antmicro/ecp5-dc-scm/img/diagram.png

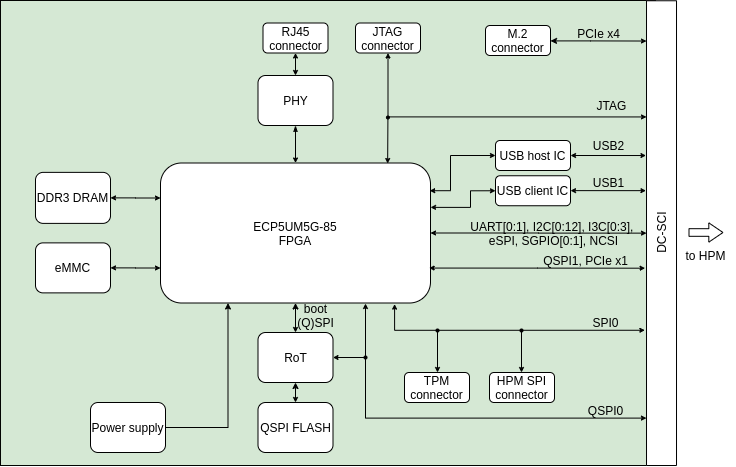
img/diagram.png
