antmicro/ecp5-dc-scm/doc/ecp5-dc-scm.pdf

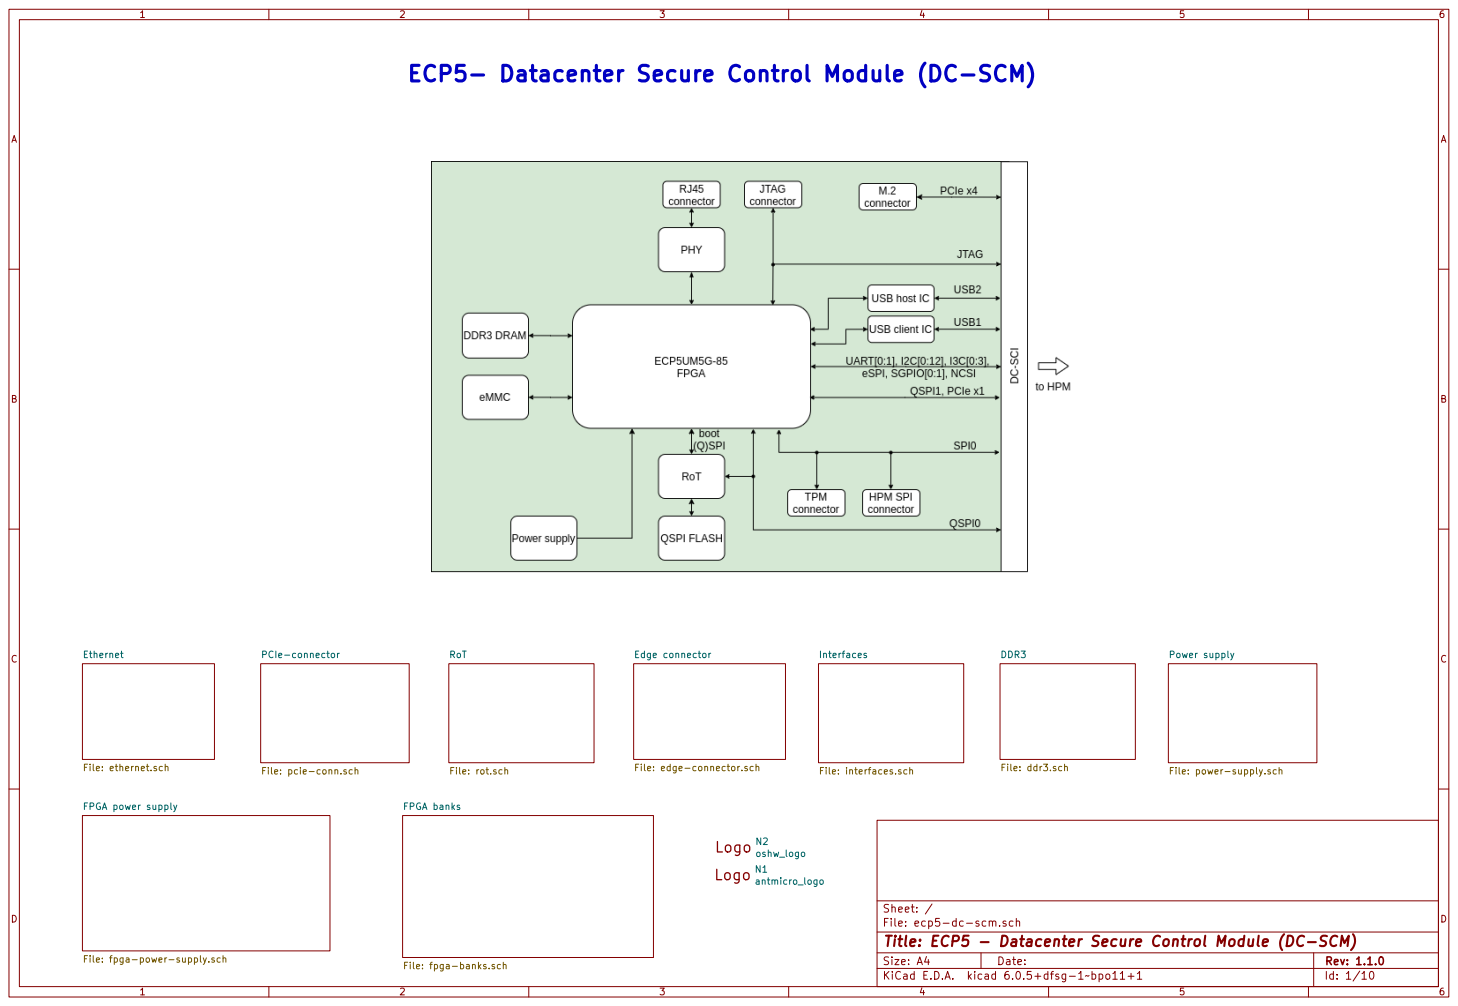
[picture p4: page 1]

ECP5- Datacenter Secure Control Module (DC-SCM)

File: ecp5-dc-scm.sch Sheet: / Edge connector

File: rot.sch FPGA power supply

File: edge-connector.sch

Id: 1/10 Title: ECP5 - Datacenter Secure Control Module (DC-SCM)

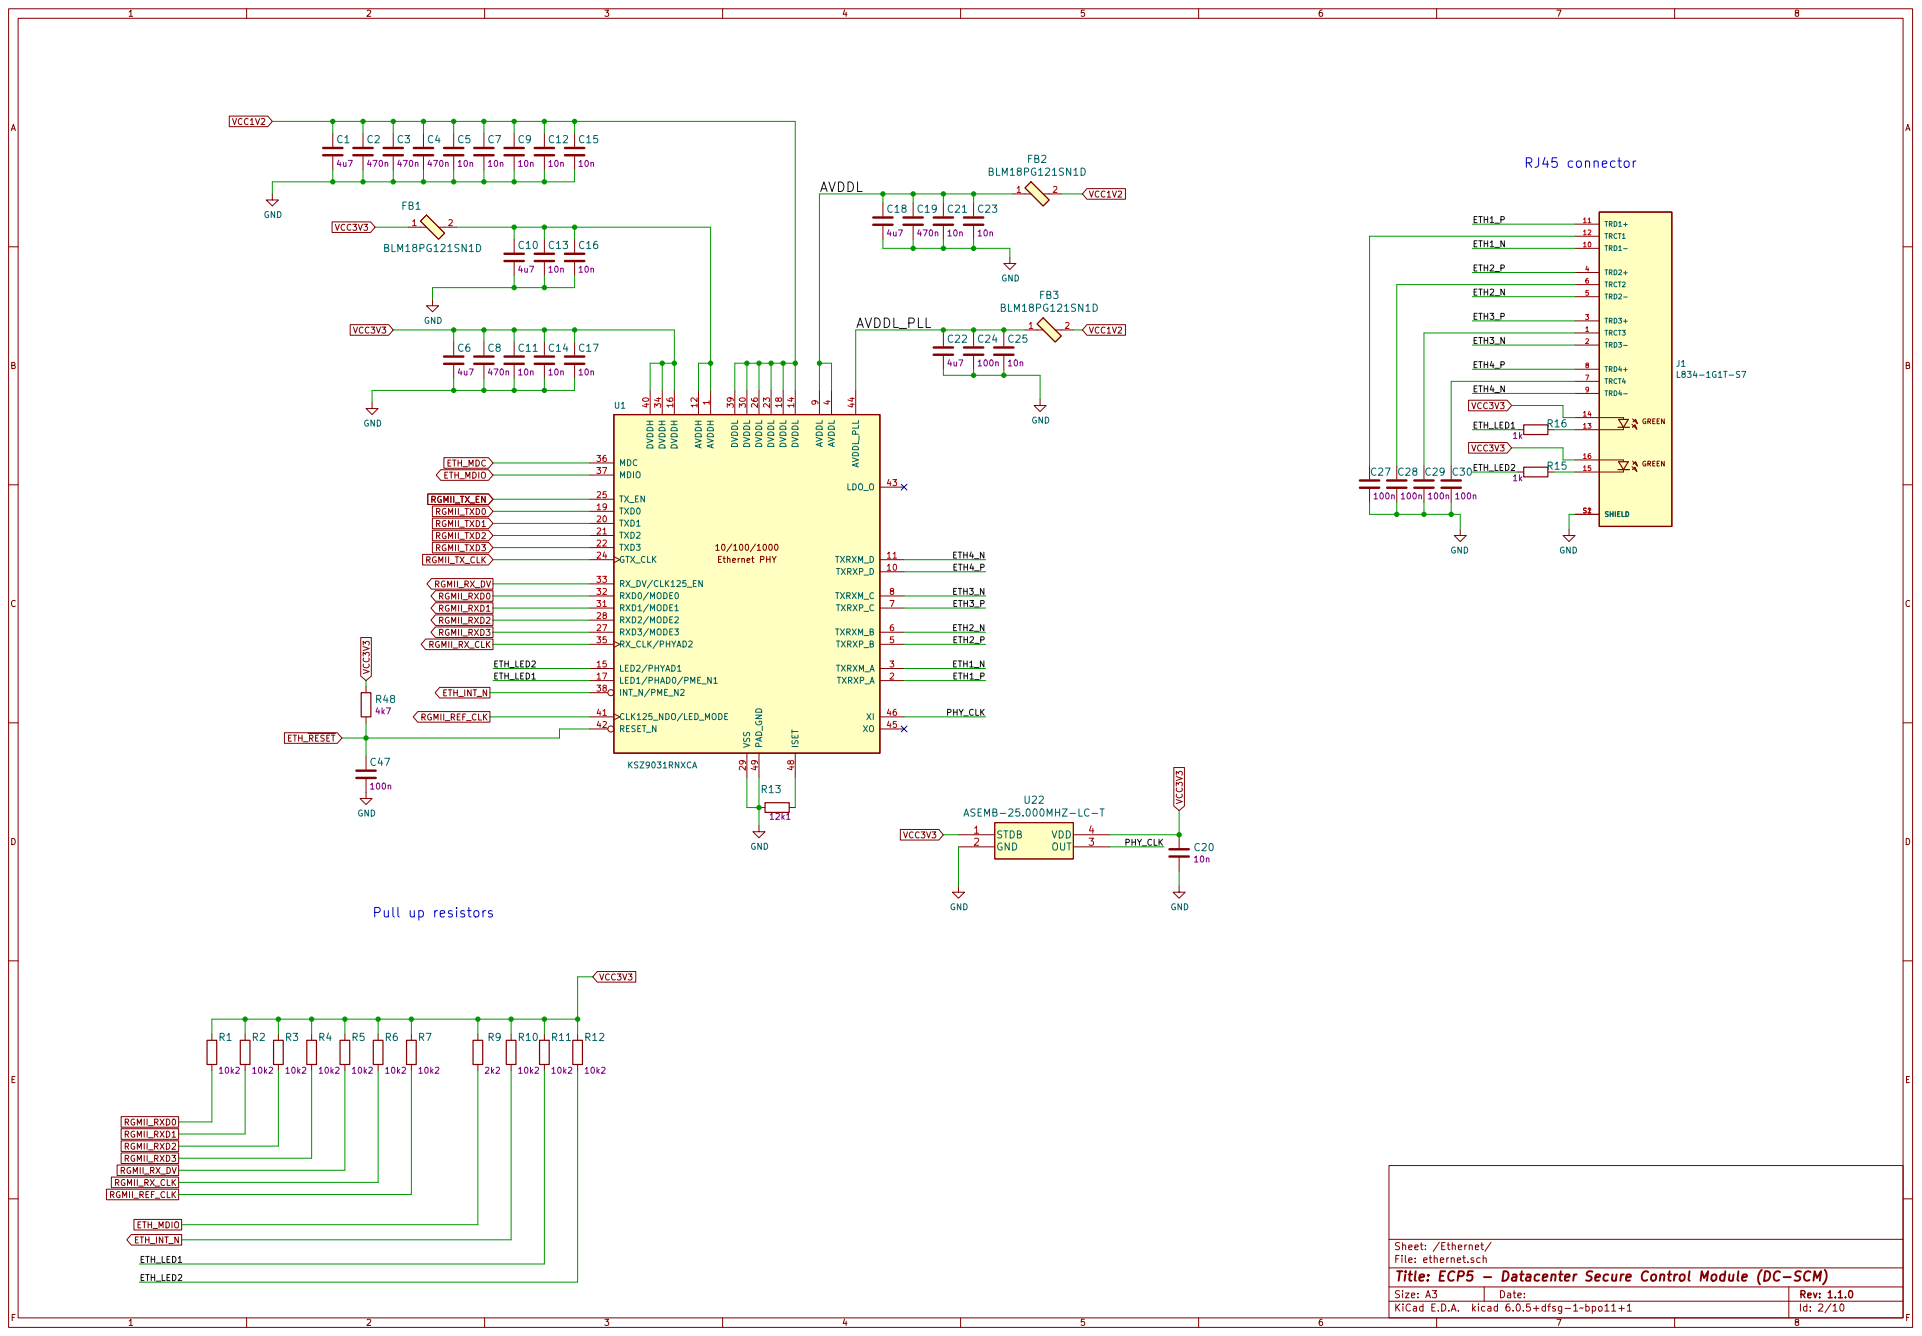
[picture p5: page 2]

Id: 2/10 Title: ECP5 - Datacenter Secure Control Module (DC-SCM) File: ethernet.sch Sheet: /Ethernet/

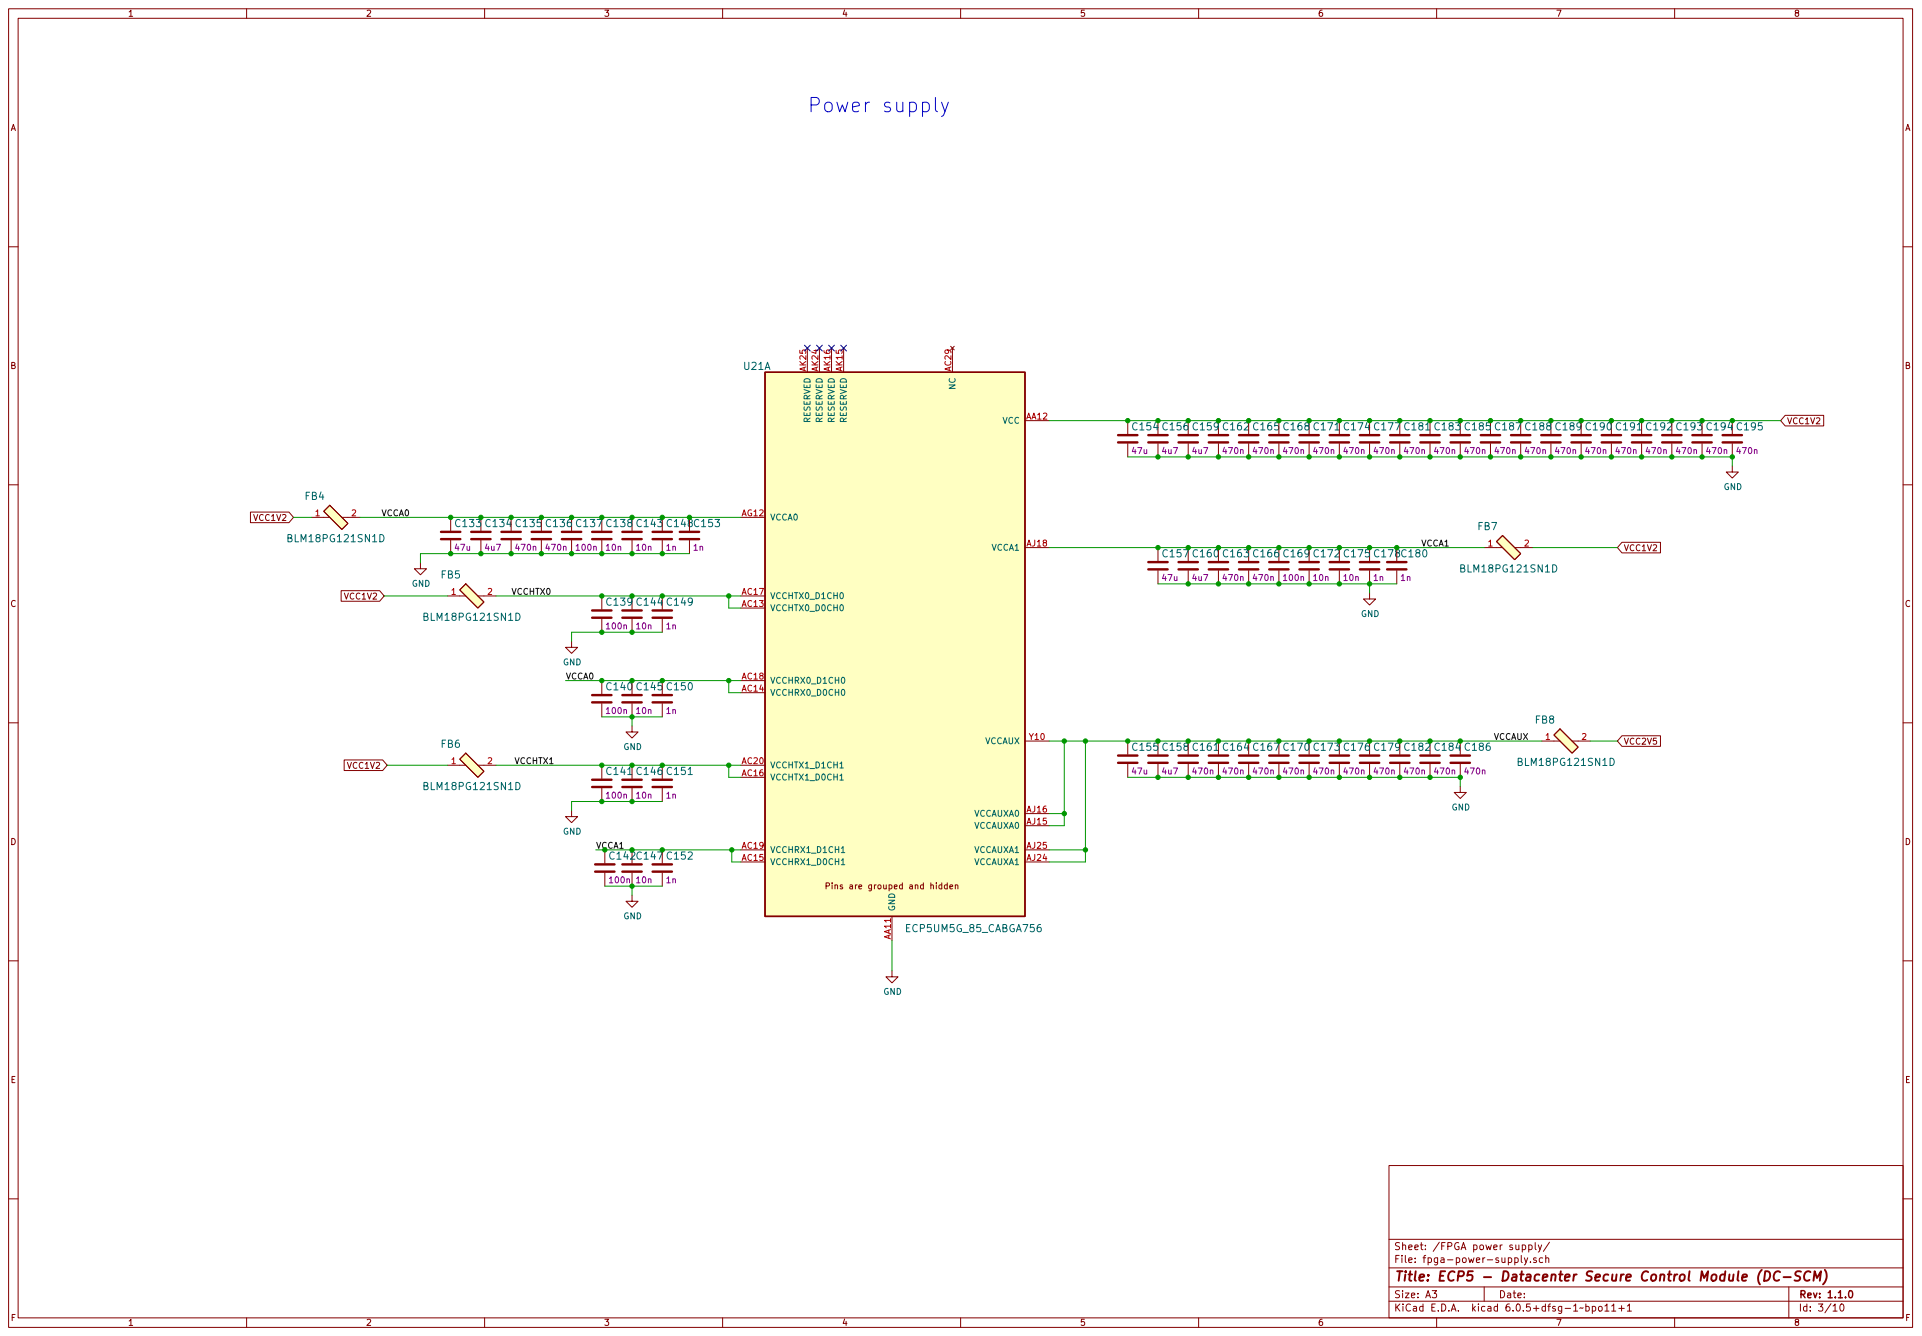
[picture p6: page 3]

Sheet: /FPGA power supply/
File: fpga-power-supply.sch
Id: 3/10 Title: ECP5 - Datacenter Secure Control Module (DC-SCM)

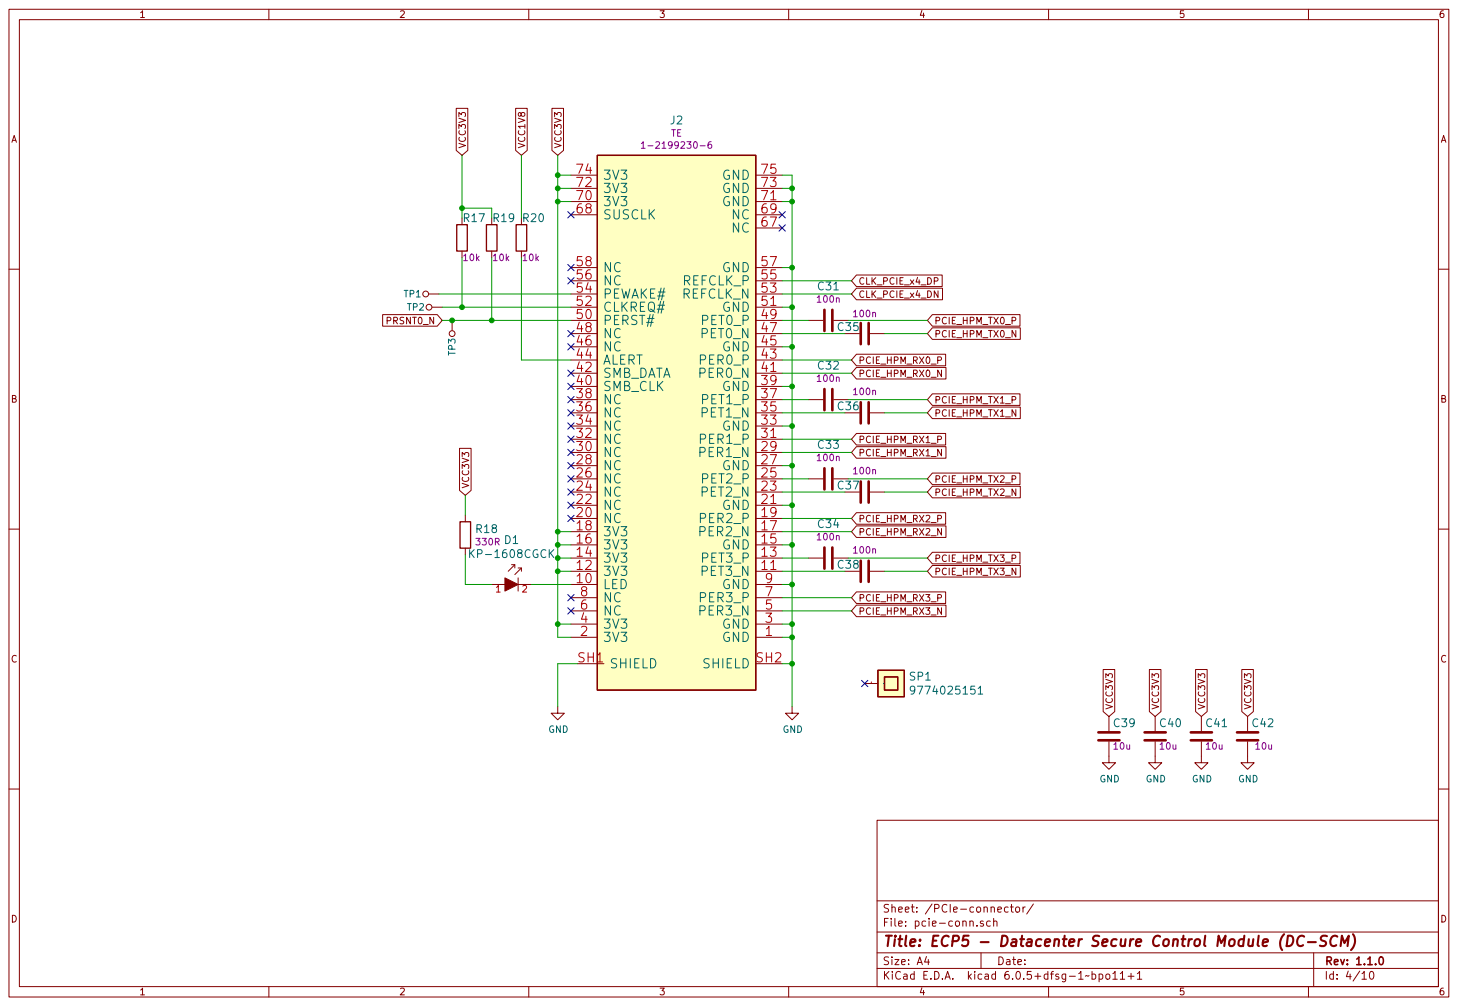
[picture p7: page 4]

1-2199230-6 GND R18
File: pcie-conn.sch Sheet: /PCIe-connector/ C34

Id: 4/10 Title: ECP5 - Datacenter Secure Control Module (DC-SCM)

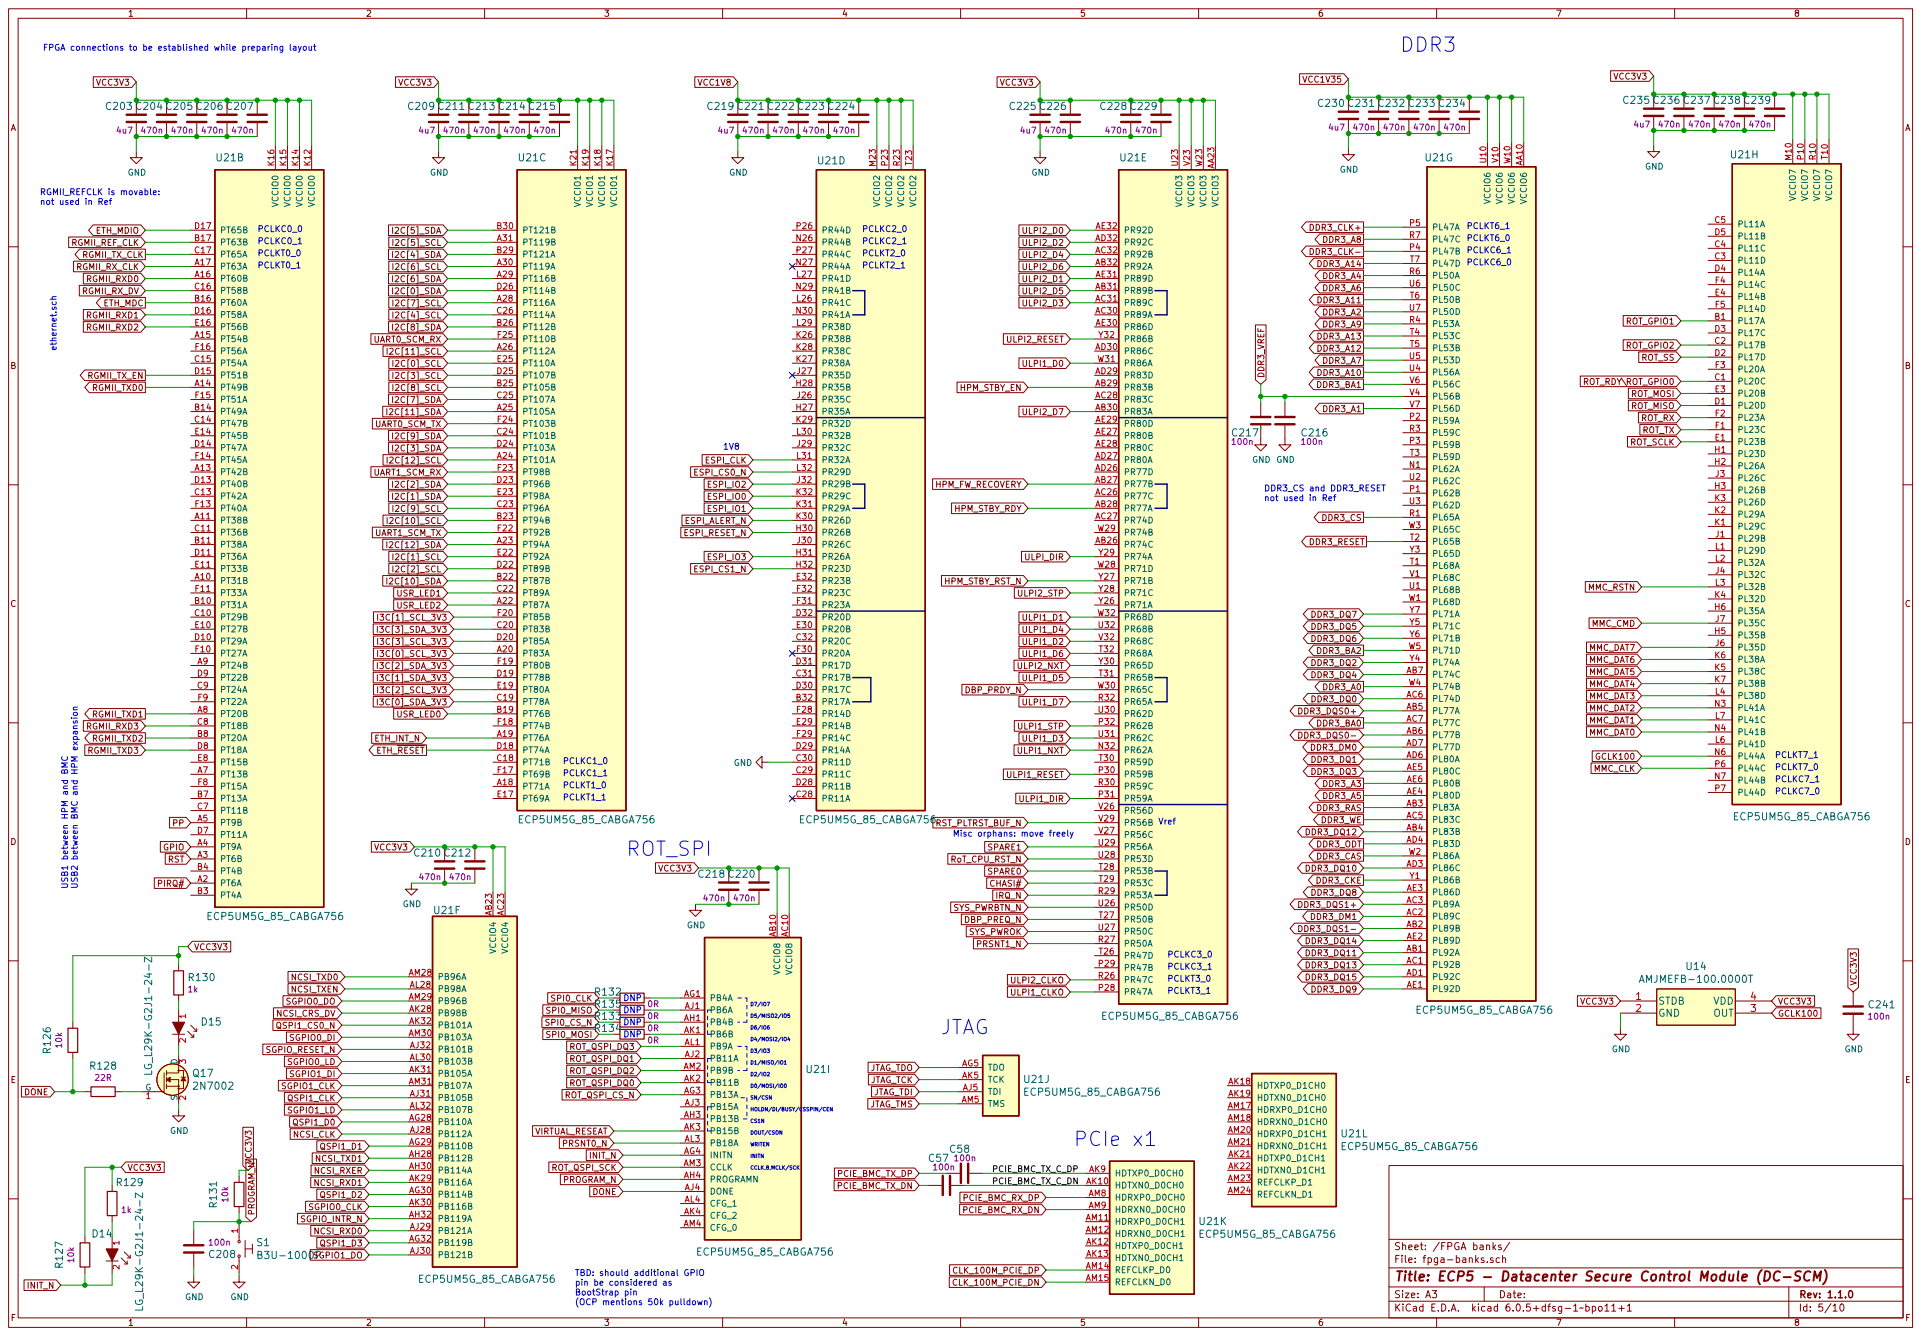
[picture p8: page 5]

FPGA connections to be established while preparing layout

PCLKC0_1 PCLKT0_0 PCLKT0_1 USB1 between HPM and BMC USB2 between BMC and HPM expansion
RGMII_TX_CLK RGMII_REF_CLK RGMII_RX_CLK RGMII_RXD0

TODO: Check and connect these misc signalls ethernet.sch

D7/IO7 D5/MISO2/IO5 D6/IO6 D4/MOSI2/IO4 D3/IO3 D1/MISO/IO1 D2/IO2 D0/MOSI/IO0 SN/CSN

HOLDN/DI/BUSY/CSSPIN/CEN

TBD: should additional GPIO
pin be considered as
BootStrap pin
(OCP mentions 50k pulldown)

Id: 5/10 Title: ECP5 - Datacenter Secure Control Module (DC-SCM)

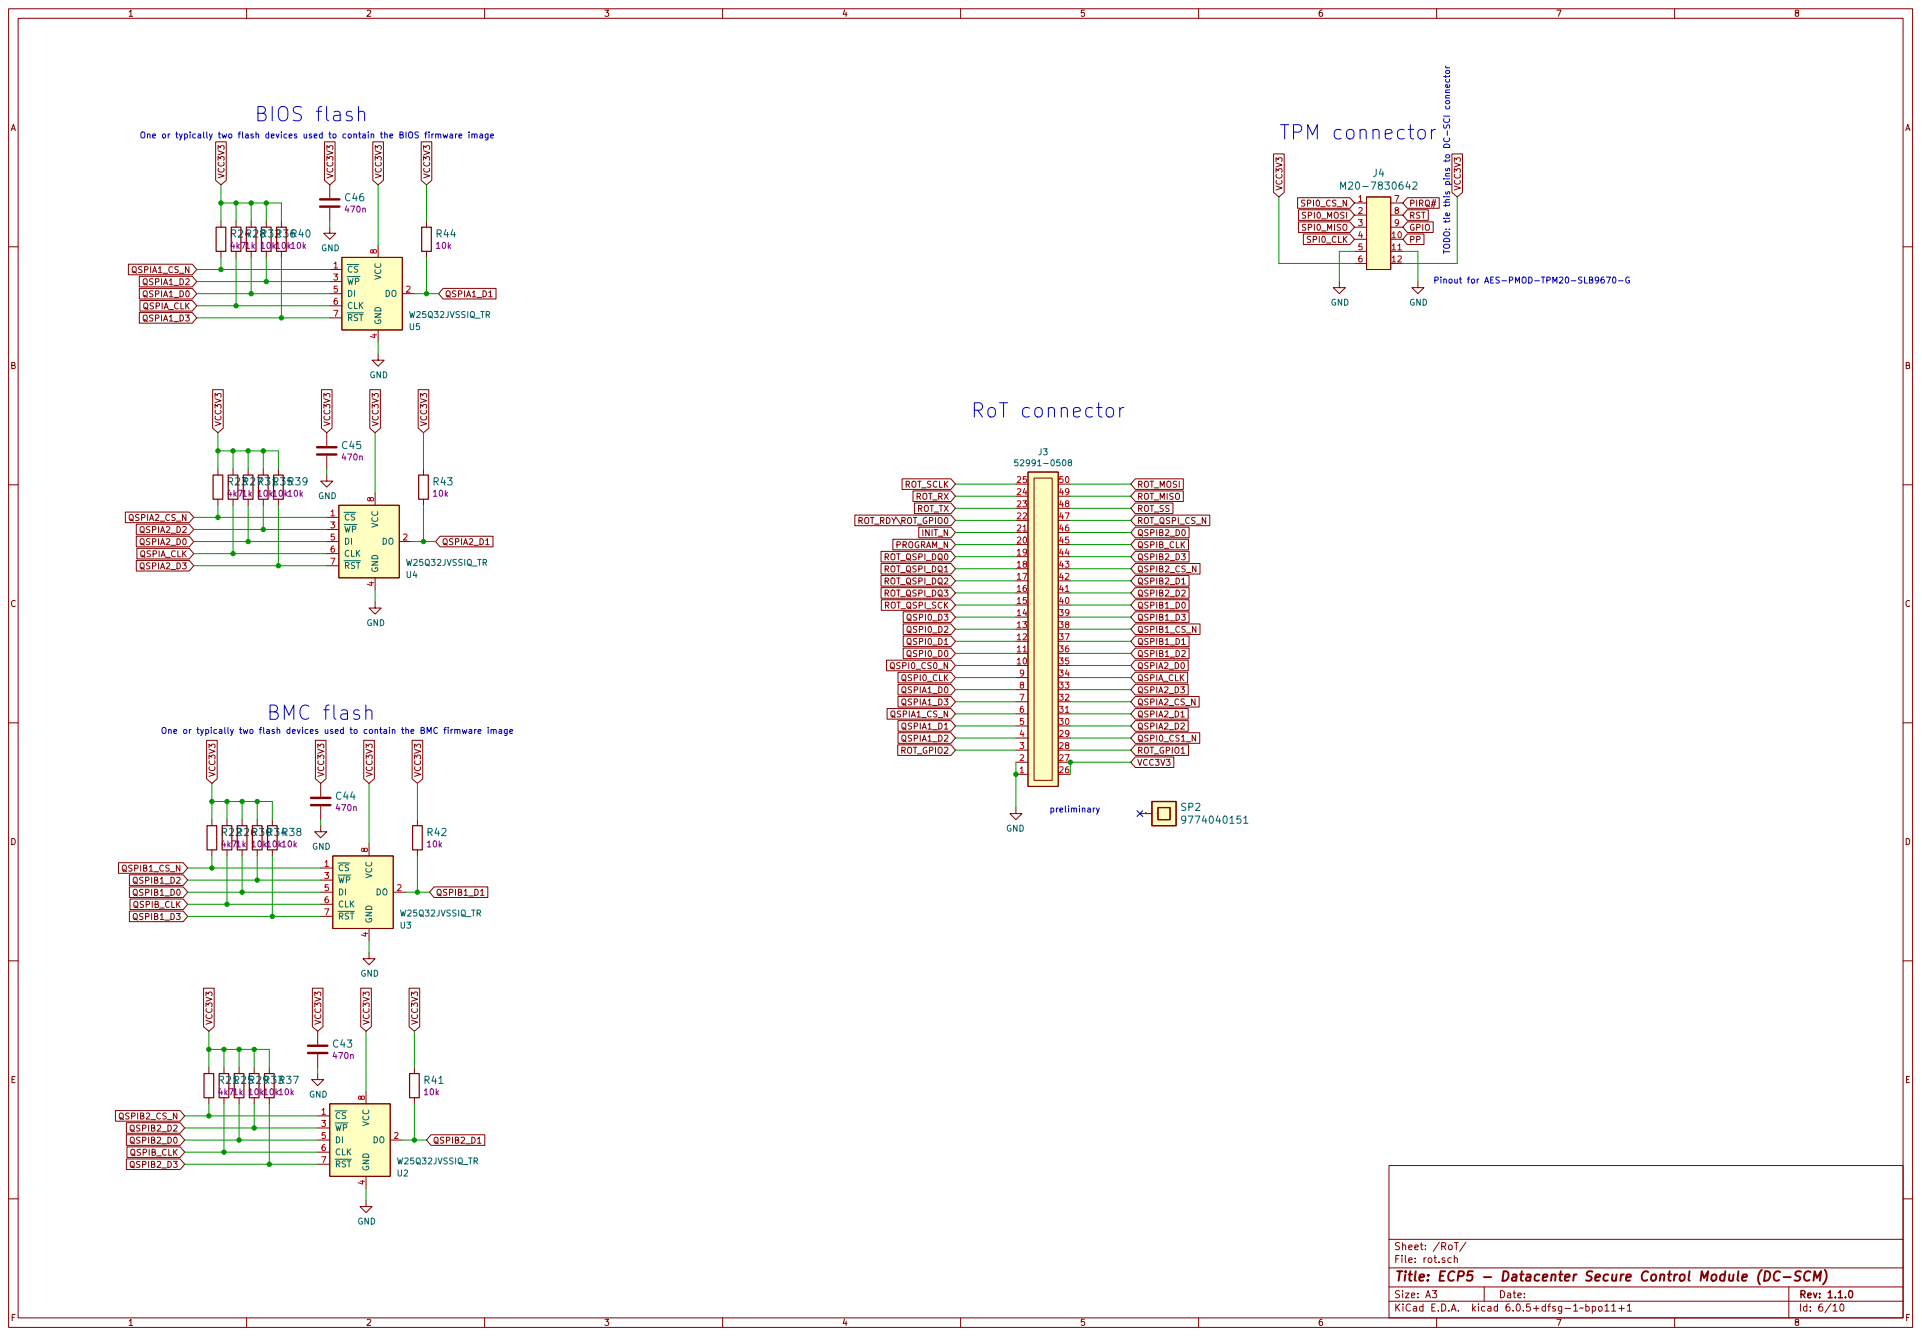
[picture p9: page 6]

One or typically two flash devices used to contain the BIOS firmware image

One or typically two flash devices used to contain the BMC firmware image

Id: 6/10 Title: ECP5 - Datacenter Secure Control Module (DC-SCM) File: rot.sch Sheet: /RoT/

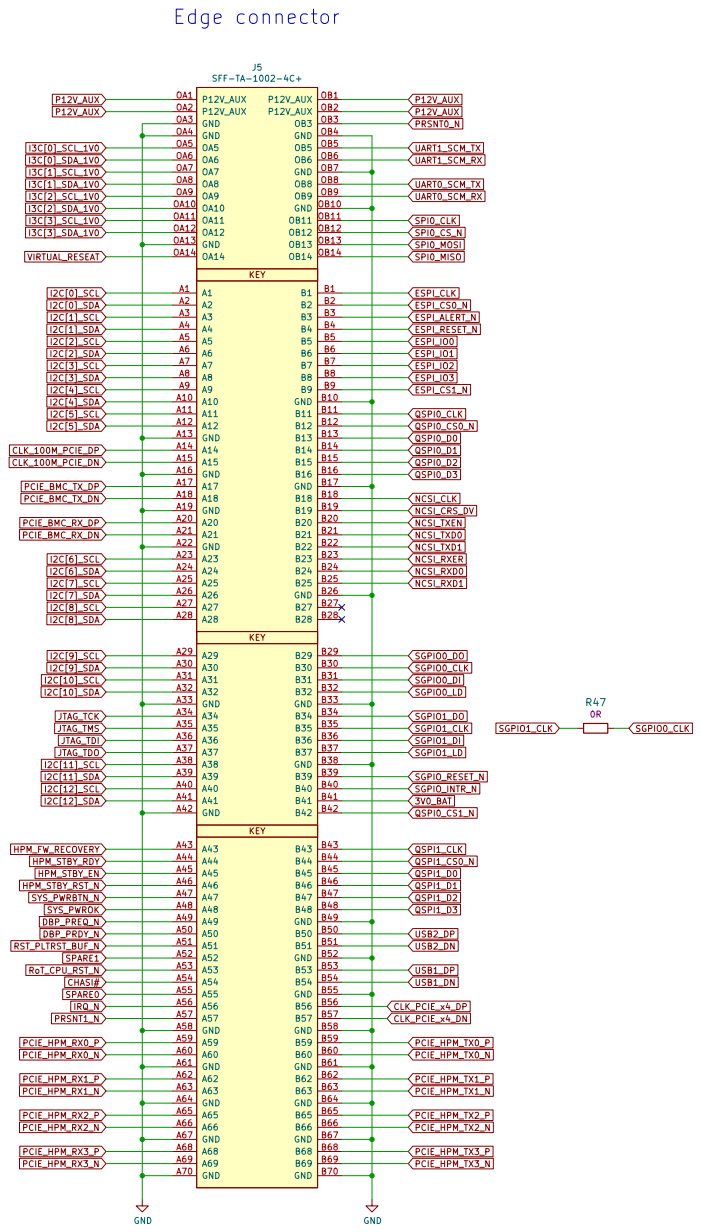
[picture p10: page 7]

File: edge-connector.sch
Id: 7/10 Title: ECP5 - Datacenter Secure Control Module (DC-SCM)

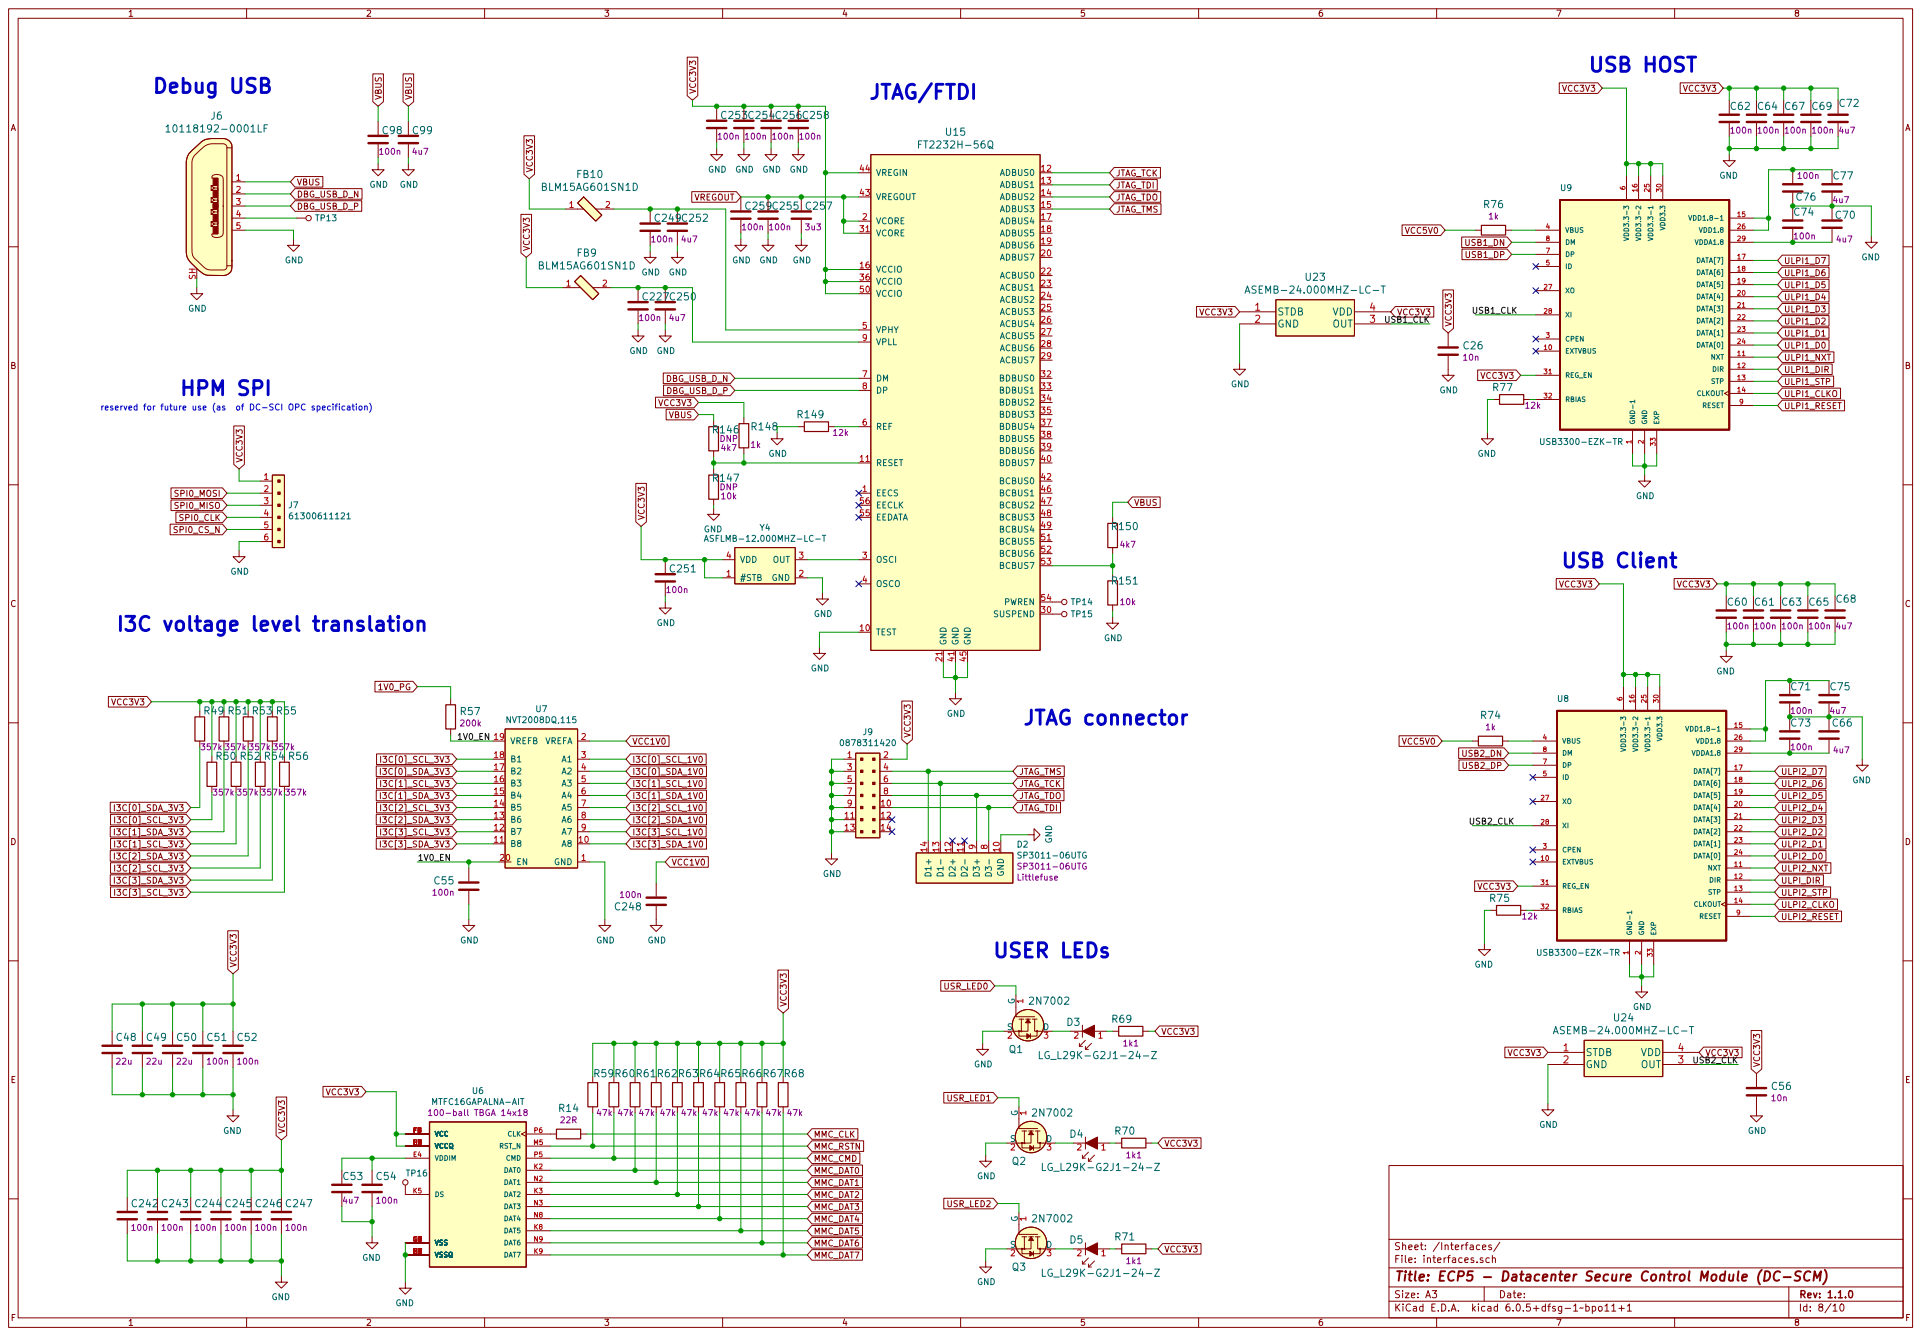
[picture p11: page 8]

2 DATA[4] 20 DATA[3] 21 DATA[2] 22 DATA[1] 23 DATA[0] 24 VDD3.3-1 25 VDD1.8

reserved for future use (as of DC-SCI OPC specification)

Id: 8/10 Title: ECP5 - Datacenter Secure Control Module (DC-SCM) File: interfaces.sch Sheet: /Interfaces/

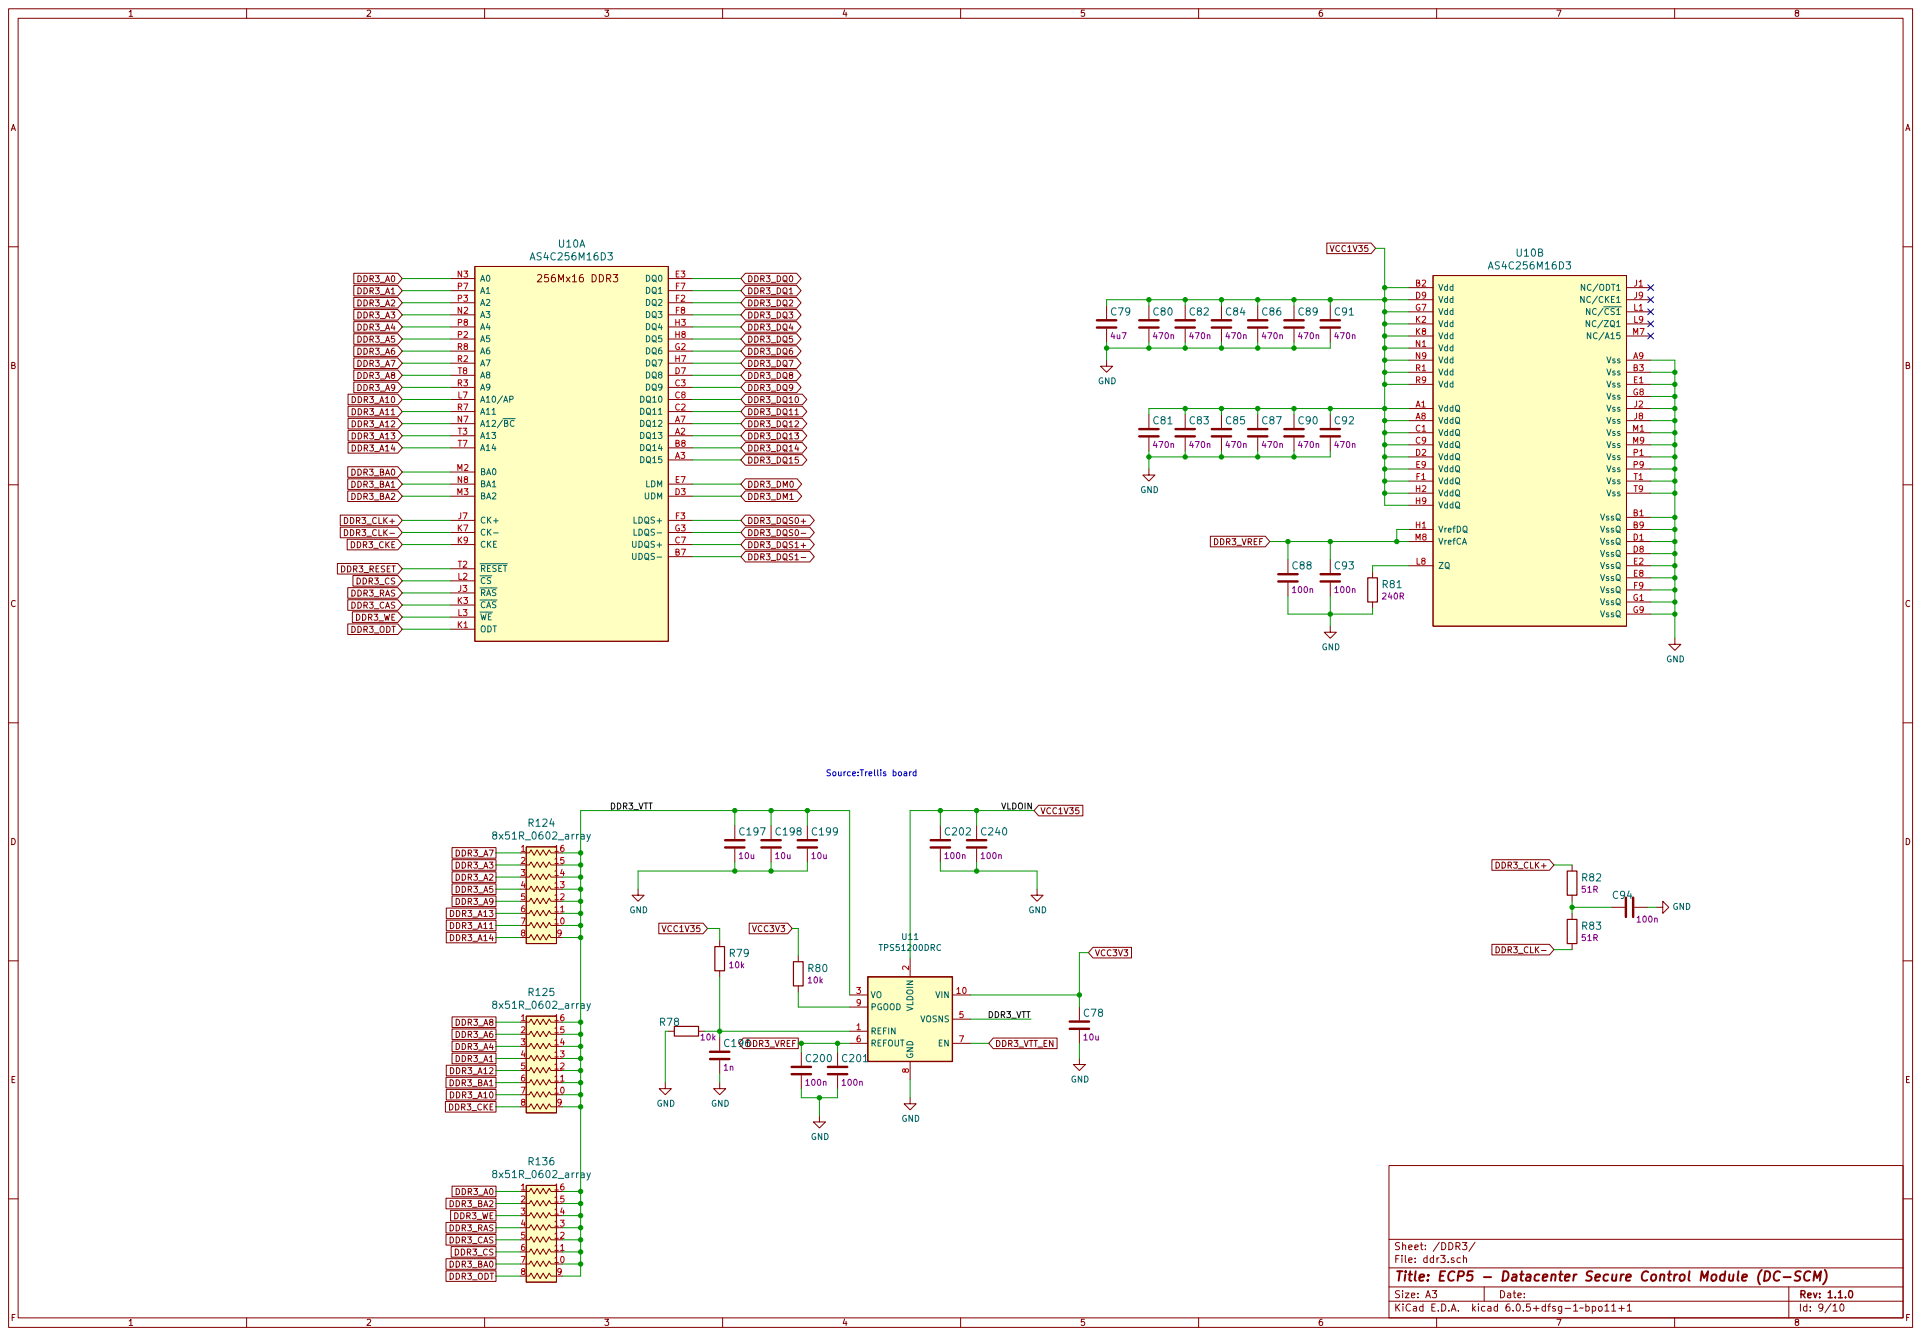
[picture p12: page 9]

2 VO 3 VOSNS 5 REFOUT 6 EN 7 GND

Id: 9/10 Title: ECP5 - Datacenter Secure Control Module (DC-SCM) File: ddr3.sch Sheet: /DDR3/

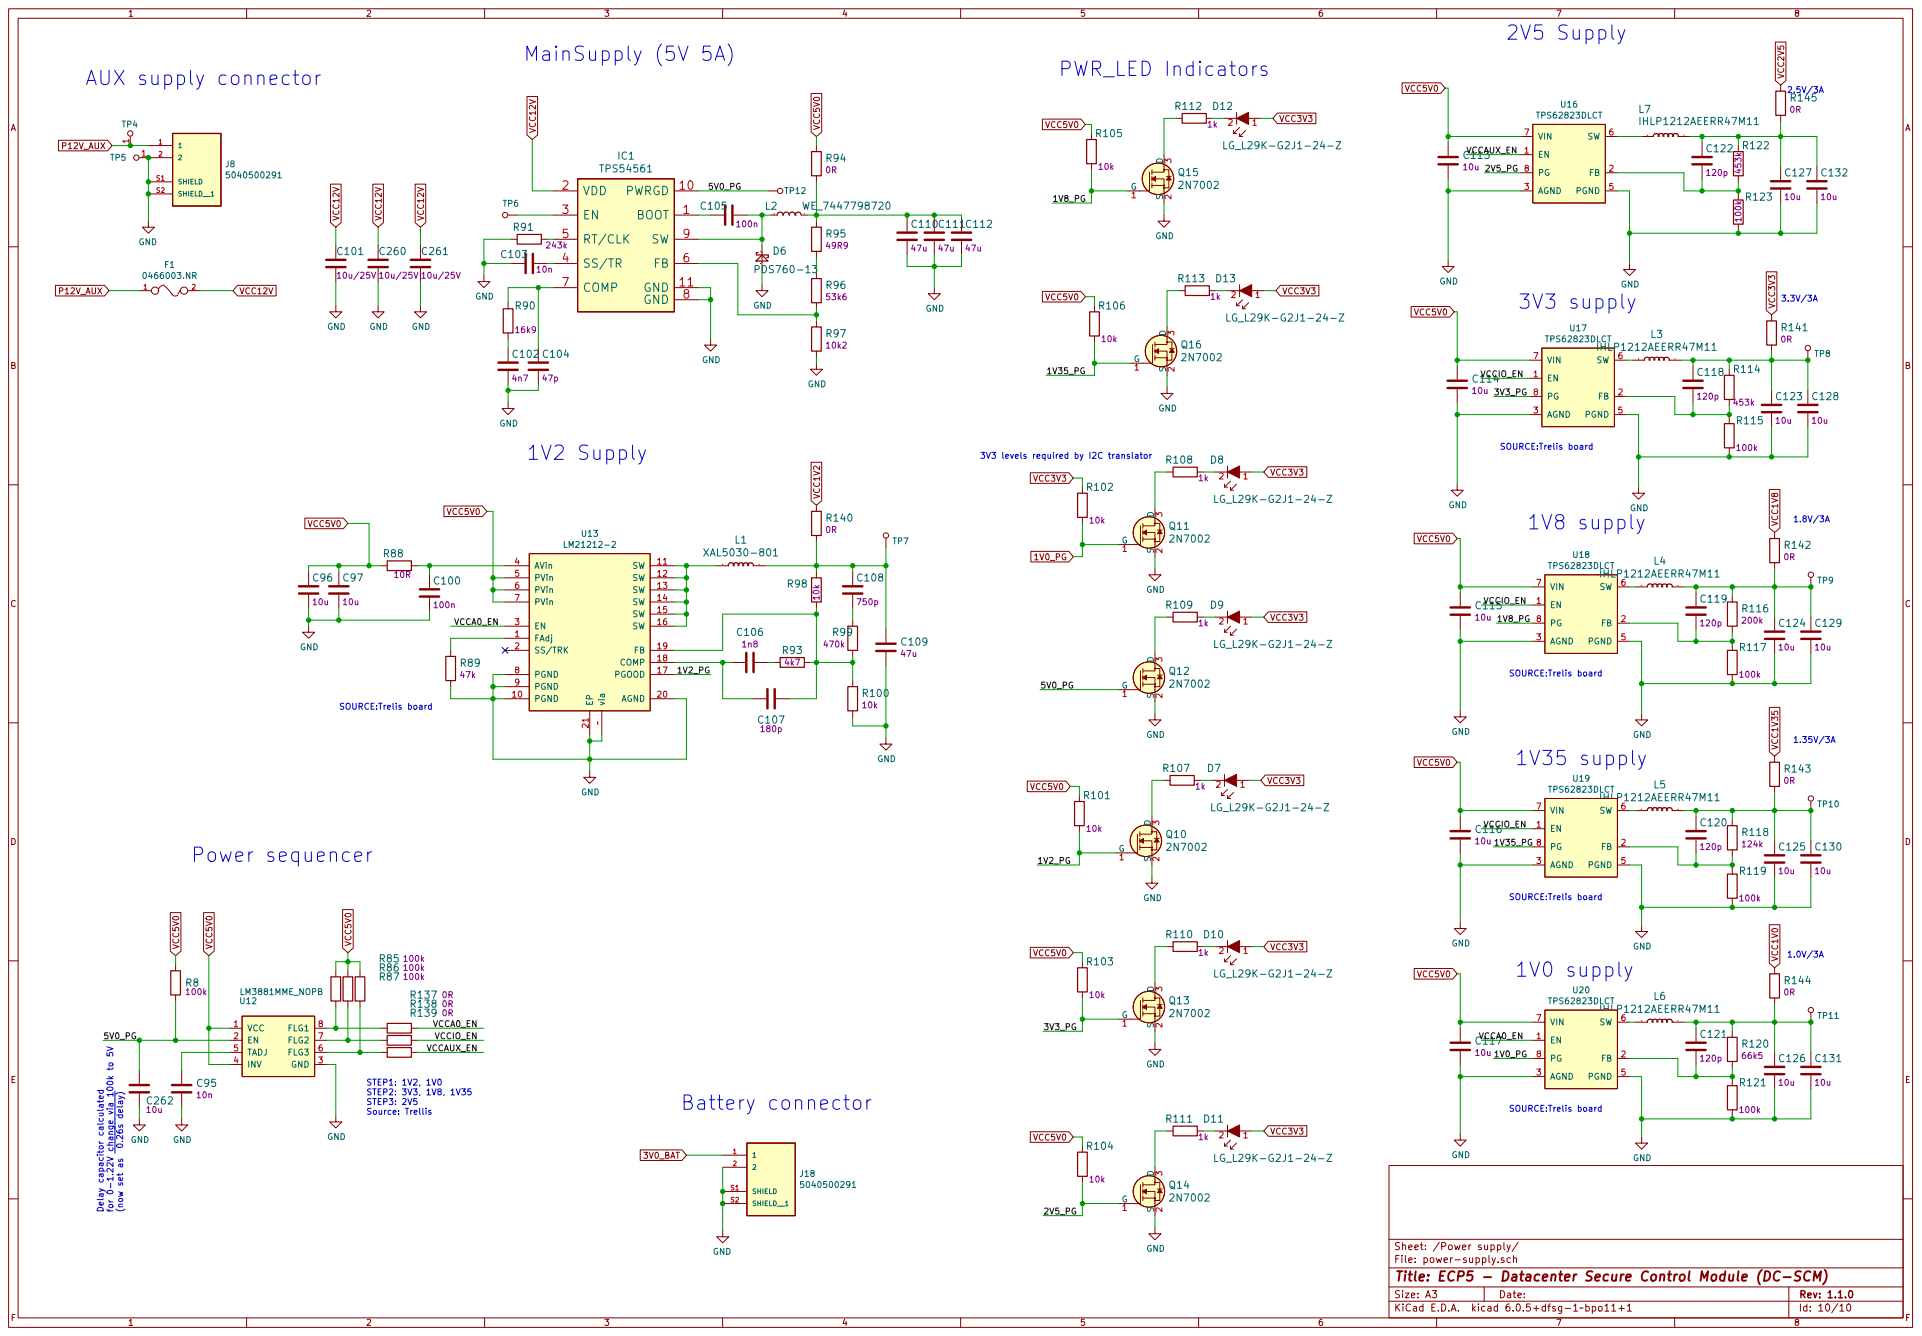
[picture p13: page 10]

1 TP4 EN 1 FB 2 AGND 3 PGND 5 SW 6 VIN 7 PG 8 U16 TPS62823DLCT

SOURCE:Trelis board 1V2 Supply

3V3 levels required by I2C translator

SOURCE:Trelis board SOURCE:Trelis board 1V0 supply

Power sequencer Delay capacitor calculated for 0-1.22V change via 100k to 5V (now set as ~{ 0.26s delay)

Sheet: /Power supply/
File: power-supply.sch
Id: 10/10 Title: ECP5 - Datacenter Secure Control Module (DC-SCM)
