antmicro/ecp5-dc-scm/ecp5-dc-scm.kicad_pcb

## KiCad design ecp5-dc-scm.kicad_pcb (2021-02-03)

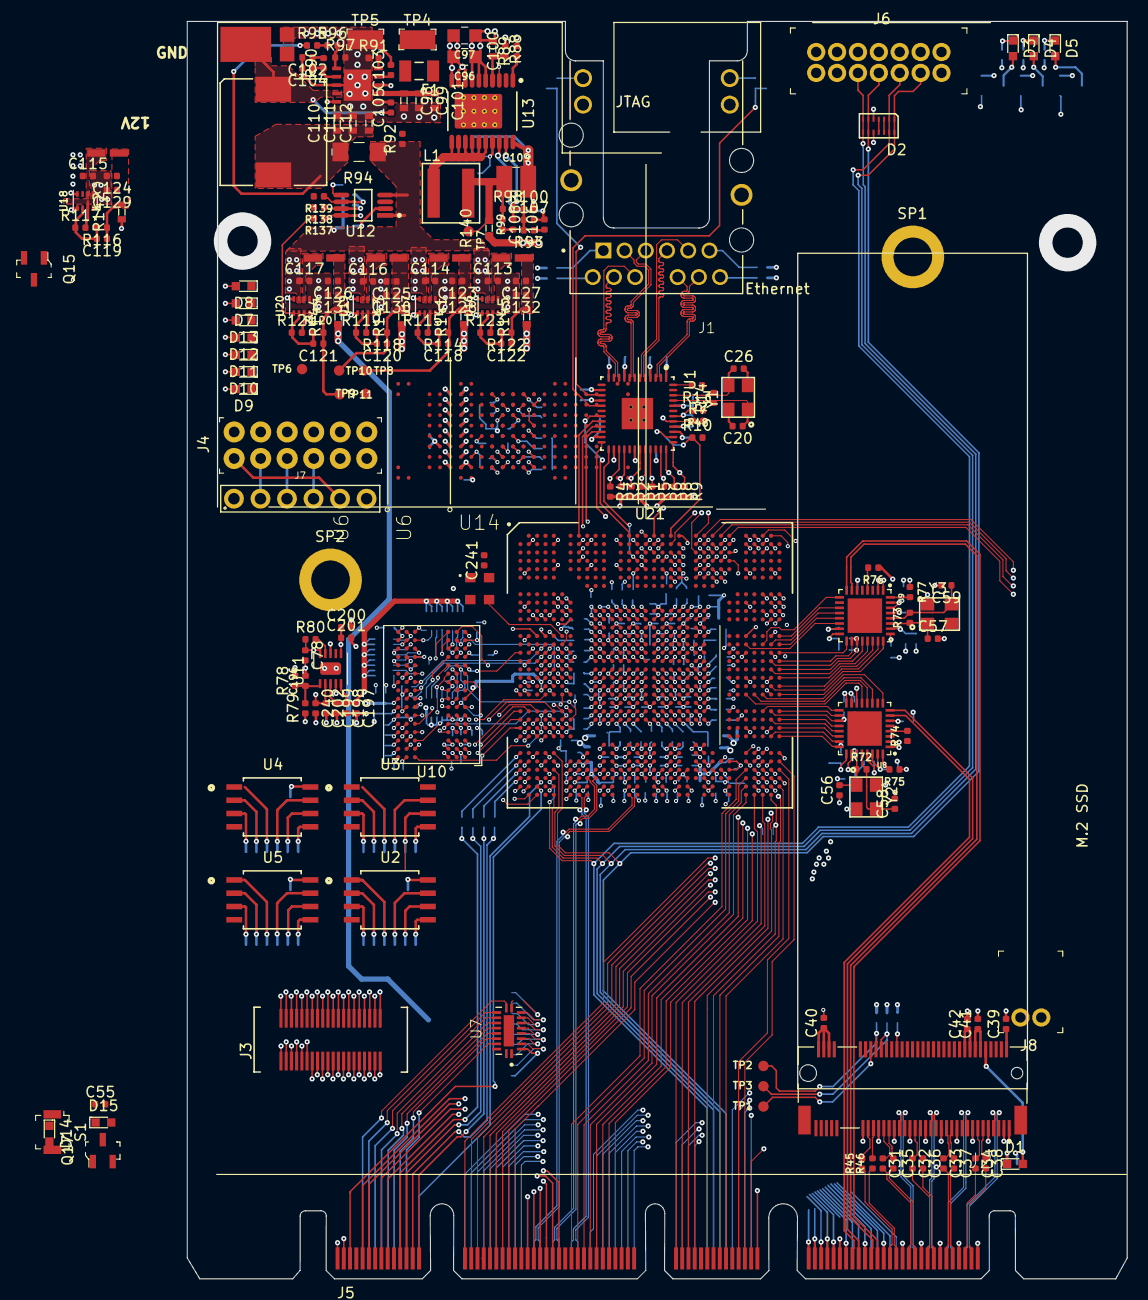
[picture p14: board ecp5-dc-scm.kicad_pcb from above]

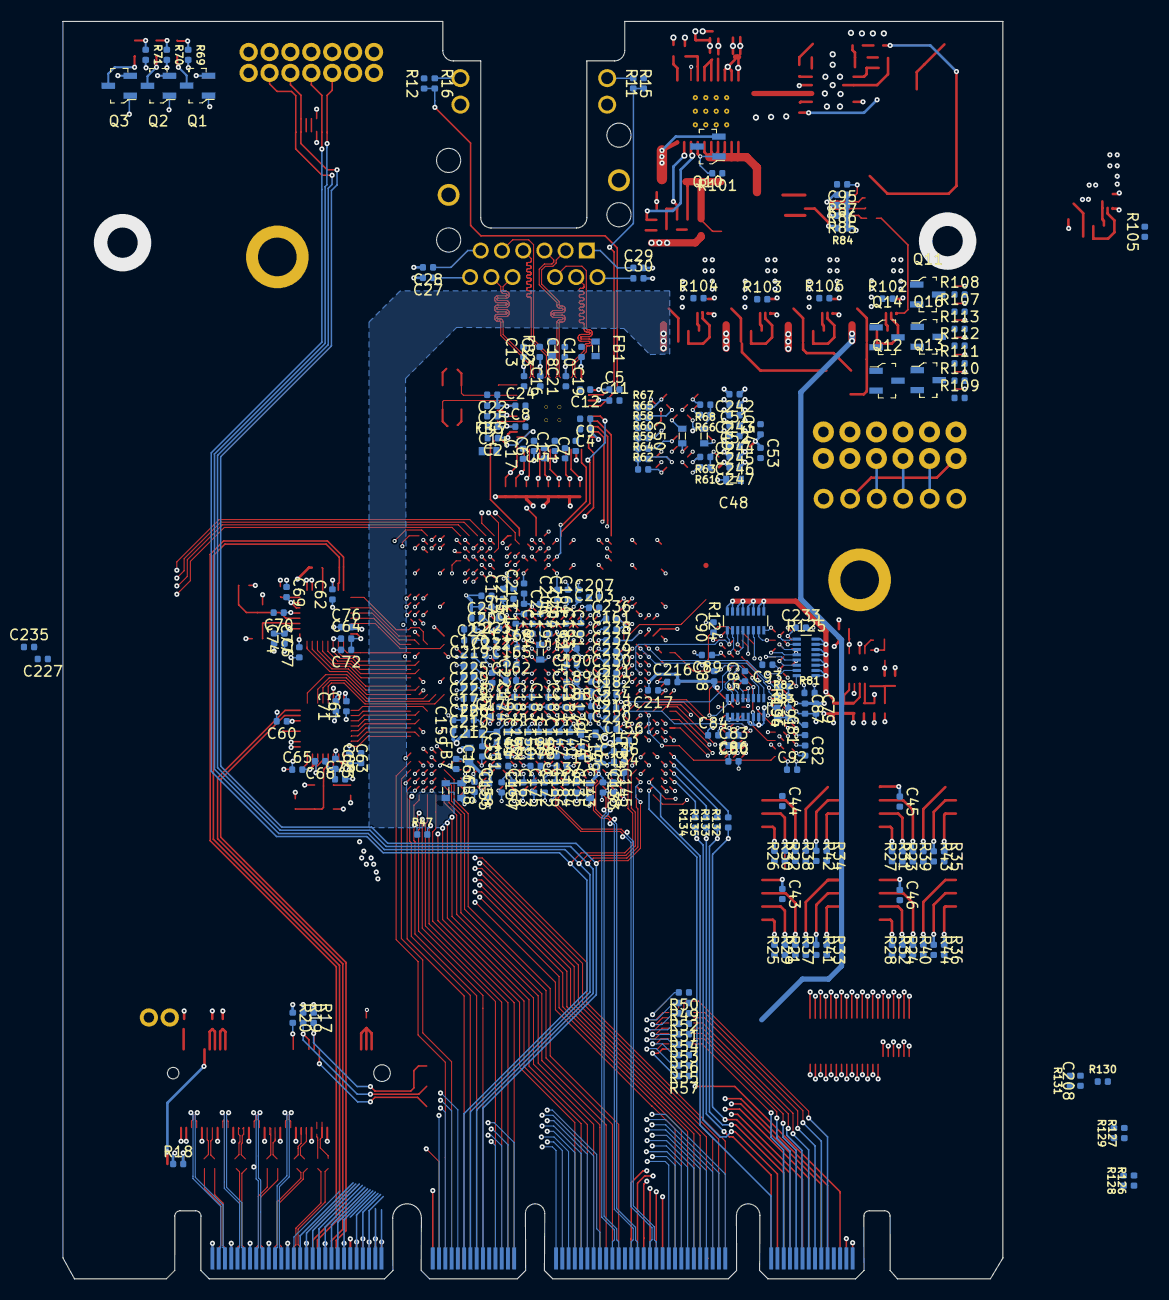
[picture p15: board ecp5-dc-scm.kicad_pcb from below]

Board: 8 copper layers, 90.0 x 120.4 mm, 481 parts (287 on the bottom side), 409 nets.

Parts:
C1, C6, C10, C18, C22, C53, C66, C68, C70, C72, C75, C77, C79, C134, C156, C158, C159, C160, C203, C209, C219, C225, C230, C235: C_4u7_0402; 0402-cap
C2, C3, C4, C8, C19, C43, C44, C45, C46, C80, C81, C82, C83, C84, C85, C86, C87, C89, C90, C91, C92, C135, C136, C161, C162, C163, C164, C165, C166, C167, C168, C170, C171, C173, C174, C176, C177, C179, C181, C182, C183, C184, C185, C186, C187, C188, C189, C190, C191, C192, C193, C194, C195, C204, C205, C206, C207, C210, C211, C212, C213, C214, C215, C218, C220, C221, C222, C223, C224, C226, C227, C228, C229, C231, C232, C233, C234, C236, C237, C238, C239: C_470n_0402; 0402-cap
C5, C7, C9, C11, C12, C13, C14, C15, C16, C17, C21, C23, C25, C95, C103, C138, C143, C144, C145, C146, C147, C172, C175: C_10n_0402; 0402-cap
C20, C26: C_22p_0402; 0402-cap
C24, C27, C28, C29, C30, C31, C32, C33, C34, C35, C36, C37, C38, C47, C51, C52, C54, C55, C60, C61, C62, C63, C64, C65, C67, C69, C71, C73, C74, C76, C88, C93, C94, C100, C105, C137, C139, C140, C141, C142, C169, C200, C201, C202, C208, C216, C217, C240, C241, C242, C243, C244, C245, C246, C247: C_100n_0402; 0402-cap
C39, C40, C41, C42, C78, C113, C114, C115, C116, C117, C123, C124, C125, C126, C127, C128, C129, C130, C131, C132, C197, C198, C199: C_10u_0402; 0402-cap
C48, C49, C50: C_22u_0603; 0603-cap
C56, C57, C58, C59: C_12p_0402; 0402-cap
C96, C97: C_10u_0805; 0805-cap
C98, C99, C101: C_2u2_0603_25V; 0603-cap
C102: C_4n7_0402; 0402-cap
C104: C_47p_0402; 0402-cap
C106: C_1n8_0402; 0402-cap
C107: C_180p_0402; 0402-cap
C108: C_750p_0402; 0402-res
C109: C_47u_1210; 1210-cap
C110, C111, C112, C133, C154, C155, C157: C_47u_0603; 0603-cap
C118, C119, C120, C121, C122: C_120p_0402; 0402-res
C148, C149, C150, C151, C152, C153, C178, C180, C196: C_1n_0402; 0402-res
D1: KP-1608CGCK; LED_0603
D2: TPD6E05U06
D3, D4, D5, D7, D8, D9, D10, D11, D12, D13, D14, D15: LG_L29K-G2J1-24-Z; LED_0603
D6: PDS760-13
F1: 0466003.NR; 1206-Fuse-Littelfuse-0466-0-0-MFG
FB1, FB2, FB3, FB4, FB5, FB6, FB7, FB8: BLM18PG121SN1D; 0603-res
IC1: TPS54561; WSON-10_4x4
J1: L834-1G1T-S7; BEL_L834-1G1T-S7
J2: 1-2199230-6
J3: 529910408
J4: M20-7830642; PinHeader_6x2_P2.54mm_Vertical
J5: SFF-TA-1002-4C+
J6: 0878311420; PinHeader_2x7_P2mm_Drill1mm
J7: 61300611121
J8: S2B-PH-K-S_LF__SN_; PinHeader_1x2_P2mm_Drill1mm_RA
L1: XAL5030-801; Coilcraft-XAL5030
L2: WE_7447798720
L3, L4, L5, L6, L7: IHLP1212AEERR47M11; IHLP-1212AE
Q1, Q2, Q3, Q10, Q11, Q12, Q13, Q14, Q15, Q16, Q17: 2N7002; SOT-23-3
R1, R2, R3, R4, R5, R6, R7, R8, R9, R10, R11, R12, R97: R_10k2_0402; 0402-res
R13: R_12k1_0402; 0402-res
R14: R_1M8_0402; 0402-res
R15, R16, R25, R26, R27, R28, R74, R76, R85, R86, R87, R107, R108, R109, R110, R111, R112, R113, R129, R130: R_1k_0402; 0402-res
R17, R19, R20, R29, R30, R31, R32, R33, R34, R35, R36, R37, R38, R39, R40, R41, R42, R43, R44, R58, R59, R60, R61, R62, R63, R64, R65, R66, R67, R68, R78, R79, R80, R98, R100, R101, R102, R103, R104, R105, R106, R126, R127, R131: R_10k_0402; 0402-res
R18: R_330R_0402; 0402-res
R21, R22, R23, R24, R48, R93: R_4k7_0402; 0402-res
R45, R46, R47, R132, R133, R134, R135, R137, R138, R139: R_0R_0402; 0402-res
R49, R50, R51, R52, R53, R54, R55, R56: R_357k_0402; 0402-res
R57, R116: R_200k_0402; 0402-res
R69, R70, R71, R84: R_1k1_0402; 0402-res
R72, R73: R_1M5_0402; 0402-res
R75, R77: R_12k_0402; 0402-res
R81: R_240R_0402; 0402-res
R82, R83: R_51R_0402; 0402-res
R88: R_10R_0603; 0603-res
R89: R_47k_0402; 0402-res
R90: R_16k9_0402; 0402-res
R91: R_243k_0402; 0402-res
R92, R115, R117, R119, R121, R123: R_100k_0402; 0402-res
R94: R_0R_1206; 1206-res
R95: R_49R9_0402; 0402-res
R96: R_53k6_0402; 0402-res
R99: R_470k_0402; 0402-res
R114, R122: R_453k_0402; 0402-res
R118: R_124k_0402; 0402-res
R120: R_66k5_0402; 0402-res
R124, R125, R136: 8x51R_0602_array; R_Array_Convex_8x0602
R128: R_22R_0402; 0402-res
R140, R141, R142, R143, R144, R145: R_0R_0603; 0603-res
S1: B3U-1000P; Switch_Tactile_SMD_B3U-1000P
SP1: 9774025151
SP2: 9774030151
TP1, TP2, TP3, TP6, TP7, TP8, TP9, TP10, TP11: TP_SMD1MM; Testpoint_smd_1mm
TP4, TP5: RCW-0C; PROBE_PAD_1206
U1: KSZ9031RNXCA; QFN-48-Microchip-QFN77-48LD-PL-2
U2, U3, U4, U5: W25Q32JVSSIQ_TR; W25Q32JVSSIQ
U6, U6#2: MTFC16GAPALNA-AIT; BGA100CP100_17X10_1800X1400X140B46N
U7: NVT2008DQ,115; QFN50P250X450X100-21N
U8, U9: USB3300-EZK-TR; QFN50P500X500X100-33N
U10: AS4C256M16D3; BGA-96_9.0x13.0mm_Layout2x3x16_P0.8mm
U11: TPS51200DRC; VSON-10-1EP_3x3mm
U12: LM3881MME_NOPB; VSSOP8-Texas_Instruments-DGK0008A
U13: LM21212-2; HTSSOP-20_TI-PWP
U14: AMJMEFB-100.0000T; AMJMEFB
U16, U17, U18, U19, U20: TPS62823DLCT; QFN-8_2x1mm
U21: ECP5UM5G_85_CABGA756; CABGA756_27x27mm_p0.8mm
Y1: ABM8G-25.000MHZ-18-D2Y-T; KX-7
Y2, Y3: TSX-3225; KX-7

Connections:
/DDR3/DDR3_VTT: C197.1, C198.1, C199.1, R124.9, R124.10, R124.11, R124.12, R124.13, R124.14, R124.15, R124.16, R125.9, R125.10, R125.11, R125.12, R125.13, R125.14, R125.15, R125.16, R136.9, R136.10, R136.11, R136.12, R136.13, R136.14, R136.15, R136.16, U11.3, U11.5
/Ethernet/AVDDL: C18.1, C19.1, C21.1, C23.1, FB2.1, U1.4, U1.9
/Ethernet/AVDDL_PLL: C22.1, C24.1, C25.1, FB3.1, U1.44
/Ethernet/ETH1_N: J1.10, U1.3
/Ethernet/ETH1_P: J1.11, U1.2
/Ethernet/ETH2_N: J1.5, U1.6
/Ethernet/ETH2_P: J1.4, U1.5
/Ethernet/ETH3_N: J1.2, U1.8
/Ethernet/ETH3_P: J1.3, U1.7
/Ethernet/ETH4_N: J1.9, U1.11
/Ethernet/ETH4_P: J1.8, U1.10
/Ethernet/ETH_LED1: R11.1, R15.2, U1.15
/Ethernet/ETH_LED2: R12.1, R16.2, U1.17
/FPGA power supply/VCCHTX0: C139.1, C144.1, C149.1, FB5.2, U21.AC13, U21.AC17
/FPGA power supply/VCCHTX1: C141.1, C146.1, C151.1, FB6.2, U21.AC16, U21.AC20
/Interfaces/1V0_EN: C55.2, R57.2, U7.2, U7.20
/Power supply/1V0_PG: Q11.1, R102.2, U20.8
/Power supply/1V2_PG: Q10.1, R101.2, U13.17
/Power supply/1V8_PG: Q15.1, R105.2, U18.8
/Power supply/1V35_PG: Q16.1, R106.2, U19.8
/Power supply/2V5_PG: Q14.1, R104.2, U16.8
/Power supply/3V3_PG: Q13.1, R103.2, U17.8
/Power supply/5V0_PG: IC1.10, R92.2
/Power supply/PWR_EN: Q12.1, R84.2, U12.2
/Power supply/VCCA0_EN: R137.2, U13.3, U20.1
/Power supply/VCCAUX_EN: R139.2, U16.1
/Power supply/VCCIO_EN: R138.2, U17.1, U18.1, U19.1
CLK_100M_PCIE_DN: J5.A13, U21.AM15
CLK_100M_PCIE_DP: J5.A12, U21.AM14
CLK_PCIE_x4_DN: J2.53, R46.2
CLK_PCIE_x4_DP: J2.55, R45.2
DDR3_A0: R136.1, U10.N3, U21.W4
DDR3_A1: R125.4, U10.P7, U21.V7
DDR3_A2: R124.3, U10.P3, U21.U7
DDR3_A3: R124.2, U10.N2, U21.AE6
DDR3_A4: R125.3, U10.P8, U21.R6
DDR3_A5: R124.4, U10.P2, U21.AE4
DDR3_A6: R125.2, U10.R8, U21.U6
DDR3_A7: R124.1, U10.R2, U21.U5
DDR3_A8: R125.1, U10.T8, U21.R7
DDR3_A9: R124.5, U10.R3, U21.R4
DDR3_A10: R125.7, U10.L7, U21.U4
DDR3_A11: R124.7, U10.R7, U21.T6
DDR3_A12: R125.5, U10.N7, U21.T5
DDR3_A13: R124.6, U10.T3, U21.T4
DDR3_A14: R124.8, U10.T7, U21.T7
DDR3_BA0: R136.7, U10.M2, U21.AC7
DDR3_BA1: R125.6, U10.N8, U21.V6
DDR3_BA2: R136.2, U10.M3, U21.W5
DDR3_CAS: R136.5, U10.K3, U21.W2
DDR3_CKE: R125.8, U10.K9, U21.Y1
DDR3_CLK+: R82.1, U10.J7, U21.P5
DDR3_CLK-: R83.2, U10.K7, U21.P4
DDR3_CS: R136.6, U10.L2, U21.R1
DDR3_DM0: U10.E7, U21.AD7
DDR3_DM1: U10.D3, U21.AC2
DDR3_DQ0: U10.E3, U21.AC6
DDR3_DQ1: U10.F7, U21.AD6
DDR3_DQ2: U10.F2, U21.Y4
DDR3_DQ3: U10.F8, U21.AE5
DDR3_DQ4: U10.H3, U21.AB7
DDR3_DQ5: U10.H8, U21.Y5
DDR3_DQ6: U10.G2, U21.Y6
DDR3_DQ7: U10.H7, U21.Y7
DDR3_DQ8: U10.D7, U21.AE3
DDR3_DQ9: U10.C3, U21.AE1
DDR3_DQ10: U10.C8, U21.AD3
DDR3_DQ11: U10.C2, U21.AB1
DDR3_DQ12: U10.A7, U21.AB4
DDR3_DQ13: U10.A2, U21.AC1
DDR3_DQ14: U10.B8, U21.AE2
DDR3_DQ15: U10.A3, U21.AD1
DDR3_DQS0+: U10.F3, U21.AB5
DDR3_DQS0-: U10.G3, U21.AB6
DDR3_DQS1+: U10.C7, U21.AC3
DDR3_DQS1-: U10.B7, U21.AB2
DDR3_ODT: R136.8, U10.K1, U21.AD4
DDR3_RAS: R136.4, U10.J3, U21.AB3
DDR3_RESET: U10.T2, U21.T2
DDR3_VREF: C88.1, C93.1, C200.1, C201.1, C216.2, C217.2, U10.H1, U10.M8, U11.6, U21.V4
DDR3_WE: R136.3, U10.L3, U21.AC5
DONE: R126.1, R128.1, U21.AJ4
ESPI_ALERT_N: J5.B3, U21.K30
ESPI_CLK: J5.B1, U21.L31
ESPI_CS0_N: J5.B2, U21.L32
ESPI_CS1_N: J5.B9, U21.H32
ESPI_IO0: J5.B5, U21.K32
ESPI_IO1: J5.B6, U21.K31
ESPI_IO2: J5.B7, U21.J32
ESPI_IO3: J5.B8, U21.H31
ESPI_RESET_N: J5.B4, U21.H30
ETH_INT_N: R10.1, U1.38, U21.A19
ETH_MDC: R8.1, U1.36, U21.B16
ETH_MDIO: R9.1, U1.37, U21.D17
ETH_~RESET: C47.1, R48.2, U1.42, U21.D18
GCLK100: U14.3, U21.N6
GND: C1.2, C2.2, C3.2, C4.2, C5.2, C6.2, C7.2, C8.2, C9.2, C10.2, C11.2, C12.2, C13.2, C14.2, C15.2, C16.2, C17.2, C18.2, C19.2, C20.2, C21.2, C22.2, C23.2, C24.2, C25.2, C26.2, C27.2, C28.2, C29.2, C30.2, C39.2, C40.2, C41.2, C42.2, C43.2, C44.2, C45.2, C46.2, C47.2, C48.2, C49.2, C50.2, C51.2, C52.2, C53.2, C54.2, C55.1, C56.2, C57.2, C58.2, C59.2, C60.1, C61.1, C62.1, C63.1, C64.1, C65.1, C66.1, C67.1, C68.2, C69.1, C70.1, C71.1, C72.2, C73.1, C74.1, C75.2, C76.1, C77.2, C78.2, C79.2, C80.2, C81.2, C82.2, C83.2, C84.2, C85.2, C86.2, C87.2, C88.2, C89.2, C90.2, C91.2, C92.2, C93.2, C94.1, C95.2, C96.2, C97.2, C98.2, C99.2, C100.2, C101.2, C102.2, C103.2, C104.2, C109.2, C110.2, C111.2, C112.2, C113.2, C114.2, C115.2, C116.2, C117.2, C123.2, C124.2, C125.2, C126.2, C127.2, C128.2, C129.2, C130.2, C131.2, C132.2, C133.2, C134.2, C135.2, C136.2, C137.2, C138.2, C139.2, C140.2, C141.2, C142.2, C143.2, C144.2, C145.2, C146.2, C147.2, C148.2, C149.2, C150.2, C151.2, C152.2, C153.2, C154.2, C155.2, C156.2, C157.2, C158.2, C159.2, C160.2, C161.2, C162.2, C163.2, C164.2, C165.2, C166.2, C167.2, C168.2, C169.2, C170.2, C171.2, C172.2, C173.2, C174.2, C175.2, C176.2, C177.2, C178.2, C179.2, C180.2, C181.2, C182.2, C183.2, C184.2, C185.2, C186.2, C187.2, C188.2, C189.2, C190.2, C191.2, C192.2, C193.2, C194.2, C195.2, C196.2, C197.2, C198.2, C199.2, C200.2, C201.2, C202.2, C203.2, C204.2, C205.2, C206.2, C207.2, C208.1, C209.2, C210.2, C211.2, C212.2, C213.2, C214.2, C215.2, C216.1, C217.1, C218.2, C219.2, C220.2, C221.2, C222.2, C223.2, C224.2, C225.2, C226.2, C227.2, C228.2, C229.2, C230.2, C231.2, C232.2, C233.2, C234.2, C235.2, C236.2, C237.2, C238.2, C239.2, C240.2, C241.2, C242.2, C243.2, C244.2, C245.2, C246.2, C247.2, D2.5, D2.10, D6.A, IC1.8, IC1.11, J1.13, J1.15, J1.S1, J1.S2, J2.1, J2.3, J2.9, J2.15, J2.21, J2.27, J2.33, J2.39, J2.45, J2.51, J2.57, J2.71, J2.73, J2.75, J2.SH1, J2.SH2, J3.1, J4.5, J4.11, J5.A11, J5.A14, J5.A17, J5.A20, J5.A33, J5.A42, J5.A58, J5.A61, J5.A64, J5.A67, J5.A70, J5.B10, J5.B17, J5.B26, J5.B33, J5.B38, J5.B49, J5.B52, J5.B55, J5.B58, J5.B61, J5.B64, J5.B67, J5.B70, J5.OA3, J5.OA4, J5.OA13, J5.OB4, J5.OB7, J5.OB10, J6.1, J6.3, J6.5, J6.7, J6.9, J6.11, J6.13, J7.6, J8.2, Q1.2, Q2.2, Q3.2, Q10.2, Q11.2, Q12.2, Q13.2, Q14.2, Q15.2, Q16.2, Q17.2, R13.1, R75.1, R77.1, R78.2, R81.2, R89.2, R91.1, R97.2, R100.2, R115.2, R117.2, R119.2, R121.2, R123.2, S1.2, TP5.1, U1.29, U1.49, U2.4, U3.4, U4.4, U5.4, U6#2.G2, U6#2.G3, U6#2.G4, U6#2.G5, U6#2.G6, U6#2.G7, U6#2.G8, U6#2.G9, U6#2.H2, U6#2.H9, U6#2.J5, U6#2.L3, U6#2.L8, U6#2.M4, U6#2.M7, U6#2.P2, U6#2.P9, U7.1, U8.1, U8.2, U8.33, U9.1, U9.2, U9.33, U10.A9, U10.B1, U10.B3, U10.B9, U10.D1, U10.D8, U10.E1, U10.E2, U10.E8, U10.F9, U10.G1, U10.G8, U10.G9, U10.J2, U10.J8, U10.M1, U10.M9, U10.P1, U10.P9, U10.T1, U10.T9, U11.4, U11.8, U11.11, U12.3, U13.8, U13.9, U13.10, U13.20, U13.21, U14.2, U16.3, U16.5, U17.3, U17.5, U18.3, U18.5, U19.3, U19.5, U20.3, U20.5, U21.AA11, U21.AA22, U21.AB11, U21.AB12, U21.AB13, U21.AB14, U21.AB15, U21.AB16, U21.AB17, U21.AB18, U21.AB19, U21.AB20, U21.AB21, U21.AB22, U21.AC12, U21.AC21, U21.AD2, U21.AD5, U21.AD28, U21.AD31, U21.AF11, U21.AF12, U21.AF14, U21.AF15, U21.AF16, U21.AF17, U21.AF19, U21.AF20, U21.AF23, U21.AG11, U21.AG14, U21.AG15, U21.AG16, U21.AG17, U21.AG20, U21.AG23, U21.AH2, U21.AH5, U21.AH7, U21.AH8, U21.AH11, U21.AH14, U21.AH15, U21.AH16, U21.AH17, U21.AH20, U21.AH23, U21.AH24, U21.AH25, U21.AH26, U21.AH29, U21.AH31, U21.AJ7, U21.AJ8, U21.AJ11, U21.AJ14, U21.AJ17, U21.AJ20, U21.AJ23, U21.AJ26, U21.AK7, U21.AK8, U21.AK11, U21.AK14, U21.AK17, U21.AK20, U21.AK23, U21.AK26, U21.AL2, U21.AL5, U21.AL7, U21.AL8, U21.AL9, U21.AL11, U21.AL12, U21.AL14, U21.AL15, U21.AL17, U21.AL18, U21.AL20, U21.AL21, U21.AL23, U21.AL24, U21.AL26, U21.AL29, U21.AL31, U21.AM7, U21.AM26, U21.B2, U21.B5, U21.B9, U21.B13, U21.B15, U21.B18, U21.B20, U21.B24, U21.B28, U21.B31, U21.C30, U21.E2, U21.E5, U21.E9, U21.E13, U21.E15, U21.E18, U21.E20, U21.E24, U21.E28, U21.E31, U21.J2, U21.J5, U21.J28, U21.J31, U21.K10, U21.K11, U21.K22, U21.K23, U21.L10, U21.L11, U21.L12, U21.L13, U21.L14, U21.L15, U21.L16, U21.L17, U21.L18, U21.L19, U21.L20, U21.L21, U21.L22, U21.L23, U21.M11, U21.M22, U21.N2, U21.N5, U21.N11, U21.N13, U21.N14, U21.N15, U21.N16, U21.N17, U21.N18, U21.N19, U21.N20, U21.N22, U21.N28, U21.N31, U21.P11, U21.P13, U21.P14, U21.P15, U21.P16, U21.P17, U21.P18, U21.P19, U21.P20, U21.P22, U21.R2, U21.R5, U21.R11, U21.R13, U21.R14, U21.R15, U21.R16, U21.R17, U21.R18, U21.R19, U21.R20, U21.R22, U21.R28, U21.R31, U21.T11, U21.T13, U21.T14, U21.T15, U21.T16, U21.T17, U21.T18, U21.T19, U21.T20, U21.T22, U21.U11, U21.U13, U21.U14, U21.U15, U21.U16, U21.U17, U21.U18, U21.U19, U21.U20, U21.U22, U21.V2, U21.V5, U21.V11, U21.V13, U21.V14, U21.V15, U21.V16, U21.V17, U21.V18, U21.V19, U21.V20, U21.V22, U21.V28, U21.V31, U21.W11, U21.W13, U21.W14, U21.W15, U21.W16, U21.W17, U21.W18, U21.W19, U21.W20, U21.W22, U21.Y2, U21.Y11, U21.Y13, U21.Y14, U21.Y15, U21.Y16, U21.Y17, U21.Y18, U21.Y19, U21.Y20, U21.Y22, U21.Y31, Y1.2, Y1.4, Y2.2, Y2.4, Y3.2, Y3.4
I2C[0]_SCL: J5.A1, U21.E25
I2C[0]_SDA: J5.A2, U21.D26
I2C[1]_SCL: J5.A3, U21.E22
I2C[1]_SDA: J5.A4, U21.E23
I2C[2]_SCL: J5.A5, U21.D22
I2C[2]_SDA: J5.A6, U21.D23
I2C[3]_SCL: J5.A7, U21.D25
I2C[3]_SDA: J5.A8, U21.D24
I2C[4]_SCL: J5.A9, U21.C26
I2C[4]_SDA: J5.A10, U21.B29
I2C[5]_SCL: J5.A21, U21.A31
I2C[5]_SDA: J5.A22, U21.B30
I2C[6]_SCL: J5.A23, U21.A30
I2C[6]_SDA: J5.A24, U21.A29
I2C[7]_SCL: J5.A25, U21.A28
I2C[7]_SDA: J5.A26, U21.C25
I2C[8]_SCL: J5.A27, U21.B25
I2C[8]_SDA: J5.A28, U21.B26
I2C[9]_SCL: J5.A29, U21.C23
I2C[9]_SDA: J5.A30, U21.C24
I2C[10]_SCL: J5.A31, U21.B23
I2C[10]_SDA: J5.A32, U21.B22
I2C[11]_SCL: J5.A38, U21.A26
I2C[11]_SDA: J5.A39, U21.A25
I2C[12]_SCL: J5.A40, U21.A24
I2C[12]_SDA: J5.A41, U21.A23
I3C[0]_SCL_1V0: J5.OA5, U7.11
I3C[0]_SCL_3V3: R50.2, U7.10, U21.A20
I3C[0]_SDA_1V0: J5.OA6, U7.12
I3C[0]_SDA_3V3: R49.2, U7.9, U21.C19
I3C[1]_SCL_1V0: J5.OA7, U7.13
I3C[1]_SCL_3V3: R52.2, U7.8, U21.F20
I3C[1]_SDA_1V0: J5.OA8, U7.14
I3C[1]_SDA_3V3: R51.2, U7.7, U21.D19
I3C[2]_SCL_1V0: J5.OA9, U7.15
I3C[2]_SCL_3V3: R54.2, U7.6, U21.E19
I3C[2]_SDA_1V0: J5.OA10, U7.16
I3C[2]_SDA_3V3: R53.2, U7.5, U21.F19
I3C[3]_SCL_1V0: J5.OA11, U7.17
I3C[3]_SCL_3V3: R56.2, U7.4, U21.D20
I3C[3]_SDA_1V0: J5.OA12, U7.18
I3C[3]_SDA_3V3: R55.2, U7.3, U21.C20
INIT_N: D14.2, J3.19, R127.1, U21.AG4
JTAG_TCK: D2.13, J5.A34, J6.6, U21.AK5
JTAG_TDI: D2.8, J5.A36, J6.10, U21.AJ5
JTAG_TDO: D2.9, J5.A37, J6.8, U21.AG5
JTAG_TMS: D2.14, J5.A35, J6.4, U21.AM5
MMC_CLK: R58.2, U6#2.P6, U21.P6
MMC_CMD: R60.2, U6#2.P5, U21.J7
MMC_DAT0: R61.2, U6#2.K2, U21.N4
MMC_DAT1: R62.2, U6#2.N2, U21.L7
MMC_DAT2: R63.2, U6#2.K3, U21.N3
MMC_DAT3: R64.2, U6#2.N3, U21.L4
MMC_DAT4: R65.2, U6#2.N8, U21.K7
MMC_DAT5: R66.2, U6#2.K8, U21.K5
MMC_DAT6: R67.2, U6#2.N9, U21.K6
MMC_DAT7: R68.2, U6#2.K9, U21.J6
MMC_RSTN: R59.2, U6#2.M5, U21.L3
NCSI_CLK: J5.B18, U21.AJ28
NCSI_CRS_DV: J5.B19, U21.AK28
NCSI_RXD0: J5.B24, U21.AJ29
NCSI_RXD1: J5.B25, U21.AK29
NCSI_RXER: J5.B23, U21.AH30
NCSI_TXD0: J5.B21, U21.AM28
NCSI_TXD1: J5.B22, U21.AH28
NCSI_TXEN: J5.B20, U21.AL28
unnamed: C10.1, C13.1, C16.1, FB1.2, U1.1, U1.12
unnamed: C20.1, R14.1, U1.45, Y1.1
unnamed: C26.1, R14.2, U1.46, Y1.3
unnamed: C27.1, J1.12
unnamed: C28.1, J1.6
unnamed: C29.1, J1.1
unnamed: C30.1, J1.7
unnamed: C31.1, J2.49
unnamed: C32.1, J2.37
unnamed: C33.1, J2.25
unnamed: C34.1, J2.13
unnamed: C35.1, J2.47
unnamed: C36.1, J2.35
unnamed: C37.1, J2.23
unnamed: C38.1, J2.11
unnamed: C53.1, C54.1, U6#2.E4
unnamed: C56.1, R72.1, U8.27, Y2.1
unnamed: C57.1, R73.1, U9.27, Y3.1
unnamed: C58.1, R72.2, U8.28, Y2.3
unnamed: C59.1, R73.2, U9.28, Y3.3
unnamed: C66.2, U8.29
unnamed: C70.2, U9.29
unnamed: C94.2, R82.2, R83.1
unnamed: C95.1, U12.5
unnamed: C100.1, R88.2, U13.4
unnamed: C102.1, R90.2
unnamed: C103.1, IC1.4
unnamed: C104.1, IC1.7, R90.1
unnamed: C105.1, D6.C, IC1.9, L2.1
unnamed: C105.2, IC1.1
unnamed: C106.1, R93.1
unnamed: C106.2, C107.2, U13.18
unnamed: C107.1, R93.2, R98.2, R99.2, R100.1, U13.19
unnamed: C108.1, C109.1, L1.2, R98.1, R140.2, TP7.1
unnamed: C108.2, R99.1
unnamed: C110.1, C111.1, C112.1, L2.2, R94.2, R95.1
unnamed: C118.1, C123.1, C128.1, L3.2, R114.1, R141.2, TP8.1
unnamed: C118.2, R114.2, R115.1, U17.2
unnamed: C119.1, C124.1, C129.1, L4.2, R116.1, R142.2, TP9.1
unnamed: C119.2, R116.2, R117.1, U18.2
unnamed: C120.1, C125.1, C130.1, L5.2, R118.1, R143.2, TP10.1
unnamed: C120.2, R118.2, R119.1, U19.2
unnamed: C121.1, C126.1, C131.1, L6.2, R120.2, R144.2, TP11.1
unnamed: C121.2, R120.1, R121.1, U20.2
unnamed: C122.1, C127.1, C132.1, L7.2, R122.1, R145.2
unnamed: C122.2, R122.2, R123.1, U16.2
unnamed: C196.1, R78.1, R79.2, U11.1
unnamed: D1.1, R18.2
unnamed: D1.2, J2.10
unnamed: D3.1, R69.1
unnamed: D3.2, Q1.3
unnamed: D4.1, R70.1
unnamed: D4.2, Q2.3
unnamed: D5.1, R71.1
unnamed: D5.2, Q3.3
unnamed: D7.2, R107.2
unnamed: D8.2, R108.2
unnamed: D9.2, R109.2
unnamed: D10.2, R110.2
unnamed: D11.2, R111.2
unnamed: D12.2, R112.2
unnamed: D13.2, R113.2
unnamed: D14.1, R129.2
unnamed: D15.1, R130.2
unnamed: D15.2, Q17.3
unnamed: IC1.3, TP6.1
unnamed: IC1.5, R91.2
unnamed: IC1.6, R96.2, R97.1
unnamed: J1.14, R15.1
unnamed: J1.16, R16.1
unnamed: J2.44, R20.2
unnamed: J2.52, R17.2, TP2.1
unnamed: J2.54, TP1.1
unnamed: J5.B56, R45.1
unnamed: J5.B57, R46.1
unnamed: L1.1, U13.11, U13.12, U13.13, U13.14, U13.15, U13.16
unnamed: L3.1, U17.6
unnamed: L4.1, U18.6
unnamed: L5.1, U19.6
unnamed: L6.1, U20.6
unnamed: L7.1, U16.6
unnamed: Q10.3, R107.1
unnamed: Q11.3, R108.1
unnamed: Q12.3, R109.1
unnamed: Q13.3, R110.1
unnamed: Q14.3, R111.1
unnamed: Q15.3, R112.1
unnamed: Q16.3, R113.1
unnamed: Q17.1, R128.2
unnamed: R13.2, U1.48
unnamed: R74.2, U8.4
unnamed: R75.2, U8.32
unnamed: R76.2, U9.4
unnamed: R77.2, U9.32
unnamed: R80.2, U11.9
unnamed: R81.1, U10.L8
unnamed: R89.1, U13.1
unnamed: R95.2, R96.1
unnamed: R132.2, U21.AG1
unnamed: R133.2, U21.AH1
unnamed: R134.2, U21.AK1
unnamed: R135.2, U21.AJ1
unnamed: R85.2, R137.1, U12.8
unnamed: R86.2, R138.1, U12.7
unnamed: R87.2, R139.1, U12.6
P12V_AUX: F1.1, J5.OA1, J5.OA2, J5.OB1, J5.OB2
PCIE_BMC_RX_DN: J5.A19, U21.AM9
PCIE_BMC_RX_DP: J5.A18, U21.AM8
PCIE_BMC_TX_DN: J5.A16, U21.AK10
PCIE_BMC_TX_DP: J5.A15, U21.AK9
PCIE_HPM_RXN[0]: J2.41, J5.A60
PCIE_HPM_RXN[1]: J2.29, J5.A63
PCIE_HPM_RXN[2]: J2.17, J5.A66
PCIE_HPM_RXN[3]: J2.5, J5.A69
PCIE_HPM_RXP[0]: J2.43, J5.A59
PCIE_HPM_RXP[1]: J2.31, J5.A62
PCIE_HPM_RXP[2]: J2.19, J5.A65
PCIE_HPM_RXP[3]: J2.7, J5.A68
PCIE_HPM_TXN[0]: C35.2, J5.B60
PCIE_HPM_TXN[1]: C36.2, J5.B63
PCIE_HPM_TXN[2]: C37.2, J5.B66
PCIE_HPM_TXN[3]: C38.2, J5.B69
PCIE_HPM_TXP[0]: C31.2, J5.B59
PCIE_HPM_TXP[1]: C32.2, J5.B62
PCIE_HPM_TXP[2]: C33.2, J5.B65
PCIE_HPM_TXP[3]: C34.2, J5.B68
PROGRAM_N: C208.2, J3.18, R131.1, S1.1, U21.AH4
PRSNT0_N: J2.50, J5.OB3, R19.2, TP3.1, U21.AL3
QSPI0_CLK: J3.7, J5.B11
QSPI0_CS0_N: J3.8, J5.B12
QSPI0_CS1_N: J3.22, J5.B42
QSPI0_D0: J3.9, J5.B13
QSPI0_D1: J3.10, J5.B14
QSPI0_D2: J3.11, J5.B15
QSPI0_D3: J3.12, J5.B16
QSPI1_CLK: J5.B43, U21.AJ31
QSPI1_CS0_N: J5.B44, U21.AK32
QSPI1_D0: J5.B45, U21.AG28
QSPI1_D1: J5.B46, U21.AG29
QSPI1_D2: J5.B47, U21.AG30
QSPI1_D3: J5.B48, U21.AG32
QSPIA1_CS_N: J3.4, R24.2, U5.1
QSPIA1_D0: J3.6, R32.1, U5.5
QSPIA1_D1: J3.3, R44.1, U5.2
QSPIA1_D2: J3.2, R36.1, U5.3
QSPIA1_D3: J3.5, R40.1, U5.7
QSPIA2_CS_N: J3.25, R23.2, U4.1
QSPIA2_D0: J3.28, R31.1, U4.5
QSPIA2_D1: J3.24, R43.1, U4.2
QSPIA2_D2: J3.23, R35.1, U4.3
QSPIA2_D3: J3.26, R39.1, U4.7
QSPIA_CLK: J3.27, R27.2, R28.2, U4.6, U5.6
QSPIB1_CS_N: J3.31, R22.2, U3.1
QSPIB1_D0: J3.33, R30.1, U3.5
QSPIB1_D1: J3.30, R42.1, U3.2
QSPIB1_D2: J3.29, R34.1, U3.3
QSPIB1_D3: J3.32, R38.1, U3.7
QSPIB2_CS_N: J3.36, R21.2, U2.1
QSPIB2_D0: J3.39, R29.1, U2.5
QSPIB2_D1: J3.35, R41.1, U2.2
QSPIB2_D2: J3.34, R33.1, U2.3
QSPIB2_D3: J3.37, R37.1, U2.7
QSPIB_CLK: J3.38, R25.2, R26.2, U2.6, U3.6
RGMII_REF_CLK: R7.1, U1.41, U21.B17
RGMII_RXD0: R1.1, U1.32, U21.A16
RGMII_RXD1: R2.1, U1.31, U21.D16
RGMII_RXD2: R3.1, U1.28, U21.E16
RGMII_RXD3: R4.1, U1.27, U21.C8
RGMII_RX_CLK: R6.1, U1.35, U21.A17
RGMII_RX_DV: R5.1, U1.33, U21.C16
RGMII_TXD0: U1.19, U21.A14
RGMII_TXD1: U1.20, U21.A8
RGMII_TXD2: U1.21, U21.B8
RGMII_TXD3: U1.22, U21.D8
RGMII_TX_CLK: U1.24, U21.C17
RGMII_TX_EN: U1.25, U21.D15
ROT_QSPI_CS_N: J3.40, U21.AG3
ROT_QSPI_DQ0: J3.17, U21.AK2
ROT_QSPI_DQ1: J3.16, U21.AJ2
ROT_QSPI_DQ2: J3.15, U21.AM2
ROT_QSPI_DQ3: J3.14, U21.AL1
ROT_QSPI_SCK: J3.13, U21.AM3
SGPIO0_CLK: J5.B30, R47.2, U21.AK30
SGPIO0_DI: J5.B31, U21.AM30
SGPIO0_DO: J5.B29, U21.AM29
SGPIO0_LD: J5.B32, U21.AL30
SGPIO1_CLK: J5.B35, R47.1, U21.AM31
SGPIO1_DI: J5.B36, U21.AK31
SGPIO1_DO: J5.B34, U21.AJ30
SGPIO1_LD: J5.B37, U21.AL32
SGPIO_INTR_N: J5.B40, U21.AH32
SGPIO_RESET_N: J5.B39, U21.AJ32
SPI0_CLK: J4.4, J5.OB11, J7.4, R132.1
SPI0_CS_N: J4.1, J5.OB12, J7.5, R133.1
SPI0_MISO: J4.3, J5.OB14, J7.3, R135.1
SPI0_MOSI: J4.2, J5.OB13, J7.2, R134.1
UART0_SCM_RX: J5.OB9, U21.F25
UART0_SCM_TX: J5.OB8, U21.F24
UART1_SCM_RX: J5.OB6, U21.F23
UART1_SCM_TX: J5.OB5, U21.F22
ULPI1_CLKO: U9.14, U21.P28
ULPI1_D0: U9.24, U21.W31
ULPI1_D1: U9.23, U21.W32
ULPI1_D2: U9.22, U21.V32
ULPI1_D3: U9.21, U21.U31
ULPI1_D4: U9.20, U21.U32
ULPI1_D5: U9.19, U21.T31
ULPI1_D6: U9.18, U21.T32
ULPI1_D7: U9.17, U21.R32
ULPI1_DIR: U9.12, U21.P31
ULPI1_NXT: U9.11, U21.N32
ULPI1_RESET: U9.9, U21.P30
ULPI1_STP: U9.13, U21.P32
ULPI2_CLKO: U8.14, U21.R26
ULPI2_D0: U8.24, U21.AE32
ULPI2_D1: U8.23, U21.AE31
ULPI2_D2: U8.22, U21.AD32
ULPI2_D3: U8.21, U21.AC31
ULPI2_D4: U8.20, U21.AC32
ULPI2_D5: U8.19, U21.AB31
ULPI2_D6: U8.18, U21.AB32
ULPI2_D7: U8.17, U21.AB30
ULPI2_NXT: U8.11, U21.Y30
ULPI2_RESET: U8.9, U21.Y32
ULPI2_STP: U8.13, U21.Y28
ULPI_DIR: U8.12, U21.Y29
USB1_DN: J5.B54, U9.8
USB1_DP: J5.B53, U9.7
USB2_DN: J5.B51, U8.8
USB2_DP: J5.B50, U8.7
USR_LED0: Q1.1, U21.B19
USR_LED1: Q2.1, U21.C22
USR_LED2: Q3.1, U21.A22
VCC1V0: R102.1, R144.1, U7.19
VCC1V2: C1.1, C2.1, C3.1, C4.1, C5.1, C7.1, C9.1, C12.1, C15.1, C154.1, C156.1, C159.1, C162.1, C165.1, C168.1, C171.1, C174.1, C177.1, C181.1, C183.1, C185.1, C187.1, C188.1, C189.1, C190.1, C191.1, C192.1, C193.1, C194.1, C195.1, FB2.2, FB3.2, FB4.1, FB5.1, FB6.1, FB7.2, R101.1, R140.1, U1.14, U1.23, U1.26, U1.30, U1.39, U21.AA12, U21.AA13, U21.AA14, U21.AA15, U21.AA16, U21.AA17, U21.AA18, U21.AA19, U21.AA20, U21.AA21, U21.M12, U21.M13, U21.M14, U21.M15, U21.M16, U21.M17, U21.M18, U21.M19, U21.M20, U21.M21, U21.N12, U21.N21, U21.P12, U21.P21, U21.R12, U21.R21, U21.T12, U21.T21, U21.U12, U21.U21, U21.V12, U21.V21, U21.W12, U21.W21, U21.Y12, U21.Y21
VCC1V8: C71.2, C73.2, C74.2, C75.1, C76.2, C77.1, C219.1, C221.1, C222.1, C223.1, C224.1, R20.1, R105.1, R142.1, U8.15, U8.26, U9.15, U9.26, U21.M23, U21.P23, U21.R23, U21.T23
VCC1V35: C79.1, C80.1, C81.1, C82.1, C83.1, C84.1, C85.1, C86.1, C87.1, C89.1, C90.1, C91.1, C92.1, C202.1, C230.1, C231.1, C232.1, C233.1, C234.1, C240.1, R79.1, R106.1, R143.1, U10.A1, U10.A8, U10.B2, U10.C1, U10.C9, U10.D2, U10.D9, U10.E9, U10.F1, U10.G7, U10.H2, U10.H9, U10.K2, U10.K8, U10.N1, U10.N9, U10.R1, U10.R9, U11.2, U21.AA10, U21.U10, U21.V10, U21.W10
VCC2V5: FB8.2, R104.1, R145.1
VCC3V3: C6.1, C8.1, C11.1, C14.1, C17.1, C39.1, C40.1, C41.1, C42.1, C43.1, C44.1, C45.1, C46.1, C48.1, C49.1, C50.1, C51.1, C52.1, C60.2, C61.2, C62.2, C63.2, C64.2, C65.2, C67.2, C68.1, C69.2, C72.1, C78.1, C203.1, C204.1, C205.1, C206.1, C207.1, C209.1, C210.1, C211.1, C212.1, C213.1, C214.1, C215.1, C218.1, C220.1, C225.1, C226.1, C227.1, C228.1, C229.1, C235.1, C236.1, C237.1, C238.1, C239.1, C242.1, C243.1, C244.1, C245.1, C246.1, C247.1, D7.1, D8.1, D9.1, D10.1, D11.1, D12.1, D13.1, FB1.1, J2.2, J2.4, J2.12, J2.14, J2.16, J2.18, J2.70, J2.72, J2.74, J3.21, J4.6, J4.12, J6.2, J7.1, R1.2, R2.2, R3.2, R4.2, R5.2, R6.2, R7.2, R8.2, R9.2, R10.2, R11.2, R12.2, R17.1, R18.1, R19.1, R21.1, R22.1, R23.1, R24.1, R25.1, R26.1, R27.1, R28.1, R29.2, R30.2, R31.2, R32.2, R33.2, R34.2, R35.2, R36.2, R37.2, R38.2, R39.2, R40.2, R41.2, R42.2, R43.2, R44.2, R48.1, R49.1, R50.1, R51.1, R52.1, R53.1, R54.1, R55.1, R56.1, R57.1, R58.1, R59.1, R60.1, R61.1, R62.1, R63.1, R64.1, R65.1, R66.1, R67.1, R68.1, R69.2, R70.2, R71.2, R80.1, R103.1, R126.2, R127.2, R129.1, R130.1, R131.2, R141.1, U1.16, U1.34, U1.40, U2.8, U3.8, U4.8, U5.8, U6#2.F2, U6#2.F3, U6#2.F4, U6#2.F5, U6#2.F6, U6#2.F7, U6#2.F8, U6#2.F9, U6#2.H3, U6#2.H8, U6#2.L2, U6#2.L4, U6#2.L7, U6#2.L9, U6#2.P3, U6#2.P8, U8.6, U8.16, U8.25, U8.30, U8.31, U9.6, U9.16, U9.25, U9.30, U9.31, U11.10, U14.1, U21.AA23, U21.AB10, U21.AB23, U21.AC10, U21.AC23, U21.K12, U21.K14, U21.K15, U21.K16, U21.K17, U21.K18, U21.K19, U21.K21, U21.M10, U21.P10, U21.R10, U21.T10, U21.U23, U21.V23, U21.W23
VCC3V3_T: C241.1, U14.4
VCC5V0: C96.1, C97.1, C113.1, C114.1, C115.1, C116.1, C117.1, R74.1, R76.1, R84.1, R85.1, R86.1, R87.1, R88.1, R92.1, R94.1, U12.1, U12.4, U13.5, U13.6, U13.7, U16.7, U17.7, U18.7, U19.7, U20.7
VCC12V: C98.1, C99.1, C101.1, F1.2, IC1.2, TP4.1
VCCA0: C133.1, C134.1, C135.1, C136.1, C137.1, C138.1, C140.1, C143.1, C145.1, C148.1, C150.1, C153.1, FB4.2, U21.AC14, U21.AC18, U21.AG9, U21.AG12, U21.AH9, U21.AH12, U21.AJ9, U21.AJ10, U21.AJ12, U21.AJ13
VCCA1: C142.1, C147.1, C152.1, C157.1, C160.1, C163.1, C166.1, C169.1, C172.1, C175.1, C178.1, C180.1, FB7.1, U21.AC15, U21.AC19, U21.AF22, U21.AG19, U21.AG22, U21.AH19, U21.AH22, U21.AJ18, U21.AJ19, U21.AJ21, U21.AJ22
VCCAUX: C155.1, C158.1, C161.1, C164.1, C167.1, C170.1, C173.1, C176.1, C179.1, C182.1, C184.1, C186.1, FB8.1, U21.AC11, U21.AC22, U21.AJ15, U21.AJ16, U21.AJ24, U21.AJ25, U21.K13, U21.K20, U21.N10, U21.N23, U21.Y10, U21.Y23
VIRTUAL_RESEAT: J5.OA14, U21.AK3
