antmicro/ecp5-dc-scm/(commit log)

2020-12-01 Create project
    [ecp5-dc-scm.kicad_pcb, ecp5-dc-scm.sch]
2020-12-01 Add FPGA banks schematic
    [ecp5-dc-scm.sch, fpga-banks.sch]
2020-12-02 Add FPGA power supply sheet
    [ecp5-dc-scm.sch, fpga-power-supply.sch]
2020-12-03 Add ethernet schematic sheet
    [ethernet.sch]
2020-12-03 Clean up designators
    [fpga-banks.sch, fpga-power-supply.sch]
2020-12-04 Add power-supply schematic sheet-WIP
    [power-supply.sch]
2020-12-07 Add missing components
    [ethernet.sch]
2020-12-07 Change power supply schematic - WIP
    [power-supply.sch]
2020-12-07 Connect RGMII to FPGA
    [fpga-banks.sch]
2020-12-07 Update main schematic file
    [ecp5-dc-scm.sch]
2020-12-07 Add DDR3 schematic sheet
    [ddr3.sch, ecp5-dc-scm.sch]
2020-12-07 Connect DDR3 to FPGA
    [fpga-banks.sch]
2020-12-08 Added flash, added interface labels to FPGA banks sheet
    [fpga-banks.sch]
2020-12-08 Added Interfaces sheet for debug and other IO connectors
    [ecp5-dc-scm.sch, interfaces.sch]
2020-12-08 Add edge connector sheet
    [ecp5-dc-scm.sch, edge-connector.sch]
2020-12-09 Cleaned up connections
    [fpga-banks.sch, interfaces.sch]
2020-12-09 Added draft sheet for RoT connector
    [rot.sch]
2020-12-09 Added M.2 connector
    [ecp5-dc-scm.sch, pcie-conn.sch]
2020-12-10 Add 1V0 power supply and sequencer
    [power-supply.sch]
2020-12-10 SPI and QSPI mostly done (to be verified)
    [fpga-banks.sch, interfaces.sch, rot.sch]
2020-12-10 Fix capacitors reference
    [ddr3.sch, edge-connector.sch, ethernet.sch, fpga-power-supply.sch, pcie-conn.sch, power-supply.sch]
2020-12-10 Added preliminary power sequencer for RoT, HPM and FPGA
    [power-supply.sch, rot.sch]
2020-12-10 Add I3C voltage level translation
    [interfaces.sch]
2020-12-11 Edit in power sequencer
    [power-supply.sch]
2020-12-11 Add PCB outline
    [ecp5-dc-scm.kicad_pcb]
2020-12-12 Fix I3C labels names
    [interfaces.sch]
2020-12-12 Add initial component placement
    [ecp5-dc-scm.kicad_pcb, fpga-banks.sch]
2020-12-12 Added TPM SPI connector
    [rot.sch]
2020-12-13 Replace DDR3 memory
    [ddr3.sch]
2020-12-13 Clean up main schematic file
    [ecp5-dc-scm.sch]
2020-12-13 Update power-supply sheet
    [power-supply.sch]
2020-12-13 Update PCB layout
    [ecp5-dc-scm.kicad_pcb]
2020-12-13 Removed inverters
    [power-supply.sch]
2020-12-13 Moved eSPI interface
    [fpga-banks.sch]
2020-12-13 Updated supplies connections
    [fpga-banks.sch, fpga-power-supply.sch, power-supply.sch]
2020-12-14 Clean up main sch file
    Separate power supply schematic
    [ecp5-dc-scm.kicad_pcb, ecp5-dc-scm.sch, power-supply-diff.sch, power-supply.sch]
2020-12-14 Update all schematic designators
    [ddr3.sch, ecp5-dc-scm.kicad_pcb, ecp5-dc-scm.sch, edge-connector.sch, ethernet.sch, fpga-banks.sch, fpga-power-supply.sch, interfaces.sch]
2020-12-14 Fix designators
    [ecp5-dc-scm.kicad_pcb, ecp5-dc-scm.sch, edge-connector.sch, interfaces.sch, power-supply.sch, rot.sch]
2020-12-14 Add ethernet and power supply component placement
    [ecp5-dc-scm.kicad_pcb]
2020-12-14 Fix outline
    [ecp5-dc-scm.kicad_pcb]
2020-12-14 Close PCB outline
    [ecp5-dc-scm.kicad_pcb]
2020-12-14 Add flash components placement
    [ecp5-dc-scm.kicad_pcb]
2020-12-14 Add DDR3 passives initial placement
    [ecp5-dc-scm.kicad_pcb]
2020-12-15 Added block diagram
    [ecp5-dc-scm.sch]
2020-12-15 Updated outline and 3D models
    [ecp5-dc-scm.kicad_pcb]
2020-12-15 Add local component libraries.
    [ddr3.sch, ecp5-dc-scm.kicad_pcb, edge-connector.sch, ethernet.sch, fpga-banks.sch, fpga-power-supply.sch, interfaces.sch, pcie-conn.sch]
2020-12-15 Updated PCIe connection
    [ecp5-dc-scm.sch, fpga-banks.sch, pcie-conn.sch]
2020-12-15 Diagram update
    [ecp5-dc-scm.sch]
2020-12-15 Add power supply placement and initial routing
    [ecp5-dc-scm.kicad_pcb]
2020-12-15 Remove DC jack connector
    [ecp5-dc-scm.kicad_pcb, power-supply.sch]
2020-12-16 Add changes to power supply sheet
    Added 1k pullup to 3V3 on PWR_EN signal
    Tied PWR_EN directly to its transistor’s gate, removed 10k pullup there
    R69 package changed to 1206
    Replaced DC jack with RCW-0C testpads (1206), tied P12V_AUX with 12V0
    [power-supply-diff.sch, power-supply.sch]
2020-12-16 Combine two power supply sheets into one
    [power-supply-diff.sch, power-supply.sch]
2020-12-16 1v2 power supply component placement
    [ecp5-dc-scm.kicad_pcb, power-supply.sch]
2020-12-16 Add PCIe passives placement
    [ecp5-dc-scm.kicad_pcb]
2020-12-17 Remove I2C and I3C goldpin connectors
    [ecp5-dc-scm.kicad_pcb, edge-connector.sch, interfaces.sch]
2020-12-17 Add power supply component placement -WIP
    [ecp5-dc-scm.kicad_pcb]
2020-12-17 Add component placement-power supply
    [ecp5-dc-scm.kicad_pcb]
2020-12-18 Add functional pins handling
    [fpga-banks.sch]
2020-12-18 Segregate decoupling capacitors
    [ecp5-dc-scm.kicad_pcb]
2020-12-20 Add decoupling capacitors placement and re-annotate
    [ddr3.sch, ecp5-dc-scm.kicad_pcb, ecp5-dc-scm.sch, ethernet.sch, fpga-banks.sch, fpga-power-supply.sch, interfaces.sch, pcie-conn.sch]
2020-12-21 Add DDR3 breakout and change its connection to FPGA
    [ddr3.sch, ecp5-dc-scm.kicad_pcb, fpga-banks.sch]
2020-12-21 Update RoT connector pinout
    [ecp5-dc-scm.kicad_pcb, rot.sch]
2020-12-22 Add USB host circuit
    [edge-connector.sch, fpga-banks.sch, interfaces.sch]
2020-12-23 Add PCIex4 clk signals filtration and standoff
    [ecp5-dc-scm.sch, edge-connector.sch, fpga-banks.sch, pcie-conn.sch]
2020-12-26 Add USB client and eMMC to schematic
    [fpga-banks.sch, interfaces.sch]
2020-12-27 Add SPI Flash pin markings and connect SGPIO1_CLK
    [edge-connector.sch, fpga-banks.sch]
2020-12-27 Fix SGPIOlabels
    [fpga-banks.sch]
2020-12-27 Fix VCC1V2 labels and add missing resistor
    [power-supply.sch]
2020-12-28 Connect SPI0 to FPGA through 0R
    [fpga-banks.sch]
2020-12-28 Add interface tabele and fix pin labels
    [ddr3.sch, edge-connector.sch, fpga-banks.sch, fpga-power-supply.sch, interfaces.sch, pcie-conn.sch]
2020-12-28 Add component placement
    [ecp5-dc-scm.kicad_pcb]
2020-12-28 Update diagram and visualisation
    [ecp5-dc-scm.sch]
2020-12-28 Update component libraries
    [ddr3.sch, ecp5-dc-scm.kicad_pcb, ecp5-dc-scm.sch, edge-connector.sch, ethernet.sch, fpga-banks.sch, fpga-power-supply.sch, interfaces.sch]
2020-12-29 Add user LEDs
    [ecp5-dc-scm.kicad_pcb, fpga-banks.sch, interfaces.sch]
2020-12-29 Fix power supply labels and power sequencing
    [power-supply.sch]
2020-12-29 Update table and add minor changes
    [fpga-banks.sch]
2020-12-29 Fix sequencing transistors connection
    [power-supply.sch]
2020-12-29 Add 1nF capacitor
    [ddr3.sch]
2020-12-29 Reconnect RGMII signals
    [ethernet.sch, fpga-banks.sch]
2020-12-29 Update eeMMC flash
    [ecp5-dc-scm.kicad_pcb, edge-connector.sch, interfaces.sch, pcie-conn.sch, power-supply.sch]
2020-12-29 Replace RJ45 connector to mid-plane
    [ecp5-dc-scm.kicad_pcb, ethernet.sch, interfaces.sch]
2020-12-30 Add USB3300-EZK-TR - USB host circuit
    [ddr3.sch, edge-connector.sch, ethernet.sch, fpga-banks.sch, fpga-power-supply.sch, interfaces.sch, pcie-conn.sch, power-supply.sch]
2020-12-30 Add second USB3300 IC - update table
    [fpga-banks.sch, fpga-power-supply.sch, interfaces.sch]
2020-12-30 Library fix
    [fpga-banks.sch, fpga-power-supply.sch, interfaces.sch]
2020-12-30 ETH pins moved to match ECPIX5. Added Eth reset circuit
    [ethernet.sch, fpga-banks.sch]
2020-12-30 Changed DDR3 and mics if connections
    [fpga-banks.sch]
2020-12-30 Add USB and PCIe routing
    Fix usb decoupling capacitors connection
    Replace 120k resistor with 12k
    [ecp5-dc-scm.kicad_pcb, interfaces.sch]
2020-12-30 Untangled SDRAM
    [ecp5-dc-scm.kicad_pcb]
2020-12-30 DDR 85% routed. Re-annotated duplicated components
    [ddr.sch, ddr3.sch, ecp5-dc-scm.kicad_pcb, ethernet.sch, interfaces.sch, pcie-conn.sch]
2020-12-31 Add M.2 PCIe and RoT routing
    [ecp5-dc-scm.kicad_pcb, fpga-banks.sch]
2020-12-31 DDR pullupus
    [ddr3.sch, ecp5-dc-scm.kicad_pcb, fpga-banks.sch]
2020-12-31 Reconnect ULPI interfaces
    [fpga-banks.sch]
2020-12-31 Add ULPI routing
    [ecp5-dc-scm.kicad_pcb]
2021-01-04 Edge conn fanout, RoT placement
    [ecp5-dc-scm.kicad_pcb, fpga-banks.sch]
2021-01-04 Update PDF schematic
2021-01-05 Routed NCSI chip corner
    [ecp5-dc-scm.kicad_pcb, fpga-banks.sch]
2021-01-07 Updated RoT connector
    [ecp5-dc-scm.kicad_pcb, rot.sch]
2021-01-07 ETH breakout
    [ecp5-dc-scm.kicad_pcb, fpga-banks.sch]
2021-01-07 ESPI routed
    [ecp5-dc-scm.kicad_pcb, fpga-banks.sch]
2021-01-07 Added 100MHz and PCLK markings on FPGA symbol
    [fpga-banks.sch]
2021-01-07 Updated power supply sequencing and labels
    [fpga-banks.sch, fpga-power-supply.sch, interfaces.sch, power-supply.sch]
2021-01-07 I3C routed
    [ecp5-dc-scm.kicad_pcb, fpga-banks.sch]
2021-02-03 Added voltage supply 0Rs and testpads, 0Rs for EN signals
    [power-supply.sch]
2021-02-03 UART routed, fixed ESPI pins
    [ecp5-dc-scm.kicad_pcb, fpga-banks.sch]
2021-02-03 Added mounting standoffs to schematics
    [pcie-conn.sch, rot.sch]
2021-02-03 I2C routed
    [ecp5-dc-scm.kicad_pcb, fpga-banks.sch]
2021-02-03 Started sketching MMC
    [ecp5-dc-scm.kicad_pcb, fpga-banks.sch]
2021-02-03 Fixed position of mounting holes
    [ecp5-dc-scm.kicad_pcb]
2021-02-03 Changed eMMC chip, some components placed
    [ecp5-dc-scm.kicad_pcb, interfaces.sch]
2021-02-03 eMMC routed
    [ecp5-dc-scm.kicad_pcb, fpga-banks.sch, rot.sch]
2021-02-03 Power supply components arranged
    [ecp5-dc-scm.kicad_pcb, power-supply.sch]
2021-02-03 Power block routed, main power planes, started FPGA pwr connection
    [ecp5-dc-scm.kicad_pcb, power-supply.sch]
2021-02-03 Adjusted FPGA cap placement
    [ecp5-dc-scm.kicad_pcb]
2021-02-03 Add ethernet diff pairs routing
    [ecp5-dc-scm.kicad_pcb]
2021-02-03 Connect user LEDs to FPGA
    [fpga-banks.sch]
2021-02-03 Add user LEDs and JTAG routing
    [ecp5-dc-scm.kicad_pcb]
2021-02-03 Add RGMII routig
    [ecp5-dc-scm.kicad_pcb]
2021-02-03 Fix diff pairs dimensions
    [ecp5-dc-scm.kicad_pcb]
2021-02-03 Add miscellaneous routing
    [ecp5-dc-scm.kicad_pcb, fpga-banks.sch]
2021-02-03 Add decoupling routing - WIP
    [ecp5-dc-scm.kicad_pcb]
2021-02-03 FPGA power connection and decoupling
    [ecp5-dc-scm.kicad_pcb]
2021-02-03 DDR3 power and decoupling
    [ecp5-dc-scm.kicad_pcb, fpga-banks.sch]
2021-02-03 Added 2.5V and 1.0V planes
    [ecp5-dc-scm.kicad_pcb]
2021-02-03 routed power indicators
    [power-supply.sch]
2021-02-03 Fixed 1V0 converter. Some minor signal routed
    [fpga-banks.sch, interfaces.sch, power-supply.sch]
2021-02-03 Routed programming mode circuit
2021-02-03 Edge power connected, resized all vias
    [fpga-banks.sch]
2021-02-03 initial connections of orphan signals
    [fpga-banks.sch]
2021-02-03 Add misc signals routing
    [fpga-banks.sch]
2021-02-03 Finish routing and fix some drc - WIP
    [fpga-banks.sch]
2021-02-03 Fix drc errors
    -Add 0.15mm traces spacing
    -Fix Power planes at VCC2
    -Add keepout areas
2021-02-03 Clean up top designators and DRC errors
    [power-supply.sch]
2021-02-03 Add JTAG/FTDI to schematic
    [interfaces.sch]
2021-02-03 Silkscreen references arranged
2021-02-03 Update FTDI schematic
    [interfaces.sch]
2021-02-03 Move components from keep-out areas
    [edge-connector.sch, ethernet.sch, interfaces.sch]
2021-02-03 Clean designators and add missing components
    [fpga-banks.sch, interfaces.sch, pcie-conn.sch, power-supply.sch]
2021-02-03 Add FTDI placement and routing
    [interfaces.sch]
2021-02-03 Update micro USB 3d model and add vbus decoupling
    [interfaces.sch]
2021-02-03 Add logos and via stitching
    [ecp5-dc-scm.sch]
2021-02-03 Replaced ROT connector, added more communication pins, connected to FPGA
    [fpga-banks.sch, rot.sch]
2021-02-03 FTDI/JTAG updated, connector added
    [ecp5-dc-scm.sch, interfaces.sch, power-supply.sch]
2021-02-03 Fixed 1.8V supplies on USB hosts
    [interfaces.sch]
2021-02-03 updated MMC pullups to 33k
    [interfaces.sch]
2021-02-03 Fixed edge connector and TPM connector footprints
    [edge-connector.sch, rot.sch]
2021-02-03 Added silkscreen markings on J7 and J8
2021-02-03 Fixed PHY pullups
    [ethernet.sch]
2021-02-03 Fixes to power sequencer circuit
    [power-supply.sch]
2021-02-03 Fixes to power sequencer on layout
2021-02-03 Replaced PHY oscillator with MEMS
    [ethernet.sch]
2021-02-03 MMC CLK pullup fix
    [interfaces.sch]
2021-02-03 Replaced USB controllers oscillators
    [interfaces.sch]
2021-02-03 updated eMMC layout
    [power-supply.sch]
2021-02-03 Added AUX supply and replaced battery connector
    [power-supply.sch]
2021-02-03 RoT standoff and connector adjust
2021-02-03 Designators cleanup
    [fpga-banks.sch, interfaces.sch]
2021-02-03 Added local libs
    [ecp5-dc-scm.sch, edge-connector.sch, ethernet.sch, interfaces.sch, power-supply.sch, rot.sch]
2021-02-03 Changed polarity of ETH_LEDx
    [ethernet.sch]
2021-02-03 Adjusted power sequencer circuit
    [power-supply.sch]
2021-02-03 Added some random GND stiching in empty areas
2021-02-03 Fixes to PCIe, orphaned signals, eMMC pullups
    [edge-connector.sch, fpga-banks.sch, interfaces.sch, pcie-conn.sch]
2021-02-03 Connected missing TPM signals
    [fpga-banks.sch]
2021-02-03 PCIe net name and routing fix
    [edge-connector.sch]
2021-02-03 Bumped revision to 1.0.1
    [ddr3.sch, ecp5-dc-scm.sch, edge-connector.sch, ethernet.sch, fpga-banks.sch, fpga-power-supply.sch, interfaces.sch, pcie-conn.sch]
2021-02-03 Fix in PCIe signal labels and differential pairs width
    [pcie-conn.sch]
2021-02-03 Bump release to 1.0.2
    [ddr3.sch, ecp5-dc-scm.sch, edge-connector.sch, ethernet.sch, fpga-banks.sch, fpga-power-supply.sch, interfaces.sch, pcie-conn.sch]
2021-02-03 Tune the length of the RGMII traces
2021-02-03 Optimize RGMII RX capacitors
2021-02-03 Bump release to 1.0.3
    [ddr3.sch, ecp5-dc-scm.sch, edge-connector.sch, ethernet.sch, fpga-banks.sch, fpga-power-supply.sch, interfaces.sch, pcie-conn.sch]
2021-11-03 Add PCB stackup table
2021-11-03 Change PCIe track width
2022-09-26 Bump revision to 1.1.0
    [ddr3.sch, ecp5-dc-scm.sch, edge-connector.sch, ethernet.sch, fpga-banks.sch, fpga-power-supply.sch, interfaces.sch, pcie-conn.sch]
2022-09-26 Fix I2C5 and PCIE connections on J5 (schematic and library symbol fix)
    [edge-connector.sch]
2022-09-26 Reroute I2C5, PCIE and GND on J9, update footprint
2022-09-28 Update PDF schematics
